Swimers/Bicycle-Crank-Cadence-Power-Meter/Doc/CadenceSensor_Schematic_Review_2026-11-01_R2.txt

CadenceSensor 原理图第二次复审（2026-11-01）

结论：上轮两项主要问题已经修正。对本次四页SVG的静态复核，未发现新的、
明确会阻止既定基本功能的严重连接或标称取值错误。可推进PCB布局与样机验证。
此结论不等于ERC通过、封装映射通过或整机实测通过；尚未锁定的物料参数见下文。

范围：Hardware/原理图/Schematic1下四页2026-11-01.svg。
全部重新读取、渲染检查；对C20、D2及其周围符号/导线检查SVG结构。
没有修改原始原理图，没有执行原始EDA的ERC、PCB DRC或上电测试。
固定10kΩ电阻为用户既定需求，本次保留，不作为待修改项。

一、上轮发现的闭环结果

1. DEC1去耦：已修正。
   C20现在为100nF，连接U3 pin1/DEC1与GND，符合QFAA参考配置。
   C13仍为DEC3到GND的100pF，正确。
   DEC2留空、DEC4的C21=1µF、VDD的C18=4.7µF及C14/C16各100nF保持合理。

2. 蜂鸣器续流：已补入，方向正确。
   新增D2=1N4148W并联在MLT-5020两端：
   阴极K接VOUT/蜂鸣器正端，阳极A接蜂鸣器负端/Q3漏极。
   正常驱动时D2反偏，关断时提供线圈电流续流路径。
   Q3 AO3400A源极接GND，漏极接蜂鸣器负端，P0.23经R28=100Ω驱动栅极，
   R30=1MΩ提供下拉，拓扑成立。
   1N4148W可作为快速续流器件候选，不需要因为其为信号二极管就一概否定。
   但必须锁定实际厂商/订货号，用相应手册核算重复峰值电流、平均电流和温升。
   不能把不同厂家的同名1N4148W额定值混用，也不能用一次性浪涌值代替重复工作能力。
   发声时用合适PWM，首板检查漏极尖峰、VOUT跌落、声压和器件温升。

二、当前关键连接复核

电源与充电：
  nPM1100的SW经L2=2.2µH到VOUT，反馈端接电感后输出，DEC/VSYS/VBAT各有对应去耦。
  pin2/pin3为高，对应3.0V；pin4/pin23/EP接地，图面连接成立。
  R11=30kΩ对应约20mA充电，VTERMSET高为标准版本4.2V目标。
  VOUT直接并联电容仍约15.3µF标称，不把DEC和RESET电容算入。
  CC1/CC2各5.1kΩ下拉；USB数据脚并接至PMIC，未见新的VBUS/GND短接。

关机/唤醒：
  POWER_OFF用P0.22；经R8=1kΩ和BAS116正向驱动SHPACT。
  R9=100kΩ位于GPIO侧下拉，R24=500kΩ位于SHPACT侧下拉。
  SW2从VBAT驱动SHPACT时，BAS116反向隔离MCU，未见VBAT直灌GPIO路径。
  SHPHLD只接R25=100kΩ上拉和SW3到GND，唤醒不依赖MCU上电。
  固件须满足Ship条件：VBUS断开并充分下降、SHPHLD高、SHPACT高至少200ms。
  开机按键SHPHLD低至少200ms；插USB也会唤醒。

MCU、复位与调试：
  三个VDD脚和全部地/裸露焊盘连接维持正确，DC/DC与两组晶振连接未见新误接。
  SW4与C19已接P0.21/RESET，不再接P0.10；SW4的3/4脚未跨接RESET/GND。
  H3定义：1=GND，2=VOUT/VTref，3=P0.21，4=SWDCLK，5=SWDIO。
  SW5为P0.11经R13=1kΩ到按键再到GND，固件需输入上拉。
  P0.21硬件RESET仍需UICR.PSELRESET配置。

加速度计：
  SC7A20H供电/去耦、GND/GNDIO、pin4接地、CS/SDO拉高与4.7kΩ上拉成立。
  I²C地址0x19，INT1接P0.13；未接INT2不阻碍使用INT1。

ADC与应变桥：
  SCLK到pin1，CS到pin2，DIN/DOUT/DRDY与MCU分配一致。
  3V模拟/数字供电、各100nF去耦、共地、CLK接地正确。
  AIN0/1接两桥臂中点，R22/R23各1kΩ、C7跨输入100nF，半桥结构成立。
  四个350Ω桥臂连续激励约8.57mA；这属于既定功耗取舍，不作为接线错误。
  外部参考脚当前未接源，固件不可选这些悬空脚作参考。

电池采样：
  Q1控制分压路径、R6=1.5MΩ/R7=220kΩ维持正确。
  4.2V电池对应约0.537V；源阻抗约192kΩ，SAADC采集时间建议20µs或更长。

三、还需完成的工程核对（与“新增严重接线错误”区分）

1. U2库文字仍需修正：pin3应为VOUTBSET0，pin4应为AVSS。
   当前分别写作VOUTBSET2、NC；实体连线正确，但库电气类型和PCB焊盘必须一起核对。
2. 完整BOM：晶振CL/ESR/精度、L2至少350mA的电流能力及DCR、MLCC偏压降容、
   350Ω桥臂精度/温漂、天线及全部封装映射尚不能仅凭SVG文字确认。
3. 蜂鸣器加入后，实测PWM峰值/平均负载，确认与无线、电桥同时工作时满足
   nPM1100的150mA供电能力，不以400mA短路限制作为正常工作能力。
4. 对ISET/MODE确认上电/复位期间确定电平；正常工作时由固件明确初始化。
5. 蜂鸣器R28=100Ω和R30=1MΩ不是当前明确的严重错误；可按驱动波形和抗扰目标
   评估330Ω栅极串阻及100kΩ下拉，不要求无依据地继续更换器件。
6. RF与模拟性能取决于后续布局、回流、天线净空、安装金属环境及标定，不能由SVG保证。

四、建议进入下一阶段的验证顺序

  A. 修库并锁BOM，原始EDA运行ERC，核对所有封装引脚和跨页网络。
  B. PCB完成后运行DRC，审查RF参考结构、电源回路、ADC输入及回流。
  C. 限流上电测各电源，验证SWD/复位、I²C身份及SPI寄存器回读。
  D. 测蜂鸣器漏极/电流/VOUT瞬态，以及其对ADC零点的影响。
  E. 测按键/GPIO关机、按键/USB唤醒、Ship电流与基本负载标定。

本次文件SHA256（固定本报告所审阅版本）：
POWER_MANAGEMENT: bb968e42b5c7332a77c9e24a6f03af16ad979e5ad7439b24f14c1aff322ced77
NRF52832_CORE_RF: 0fad743ca535fc436a7543a417cb64fc285b46d731420940ea0d7a61f025206b
SC7A20H_SENSOR: 6845124e2240f5803672248ecea050c5fe68a393cf399f63cb17c3dc72e3819a
ADS1220_STRAIN: 63bb2a94d8f3483bb749cd8f81aa7866bbf3550b0bddcbf3a4d9f8863cf369e8

主要参考：
https://docs.nordicsemi.com/r/bundle/ps_nrf52832/page/ref_circuitry.html
https://www.diodes.com/part/view/1N4148W/
https://www.vishay.com/docs/86356/1n4148w.pdf
上述两家二极管资料用于说明同型号存在额定条件差异，不能代替实际采购BOM。
