Swimers/Bicycle-Crank-Cadence-Power-Meter/Doc/CadenceSensor_Uploaded_Schematic_Review_2026-10-30.txt

CadenceSensor 上传版四页SVG审阅与关键物料核查（2026-10-30）

结论：没有发现新的VBAT直灌MCU路径，关机隔离、SPI、核心供电拓扑基本成立。
但仍有确定的复位按键网络错误，以及电磁蜂鸣器缺少钳位、3V驱动选型保证不足。
应先处理这些问题，再进行PCB/ERC和上电验证。
目前不能把所有元器件型号与取值认定为已通过：晶振、电感、电容、天线及精密电阻
缺少完整物料规格，蜂鸣器也需要锁定厂家和版本。

审阅对象：本次用户上传的临时目录文件，不以仓库里较早的SVG代替：
SCH_Schematic1_1-POWER_MANAGEMENT_2026-10-30 (2).svg
SCH_Schematic1_2-NRF52832_CORE_RF_2026-10-30 (2).svg
SCH_Schematic1_3-SC7A20H_SENSOR_2026-10-30 (2).svg
SCH_Schematic1_4-ADS1220_STRAIN_2026-10-30 (2).svg
已逐页渲染，检查关键网络标签及部分引脚/导线的SVG坐标，并对照器件资料。
没有原始EDA网络表、完整BOM和PCB，未执行ERC/DRC或上电实测，未修改原图。
电池NTC使用固定10kΩ是用户确认的需求，本次不列为修改项。

一、需要优先处理的问题

1. [确定的连接错误] 第2页 SW4/C13接P0.10，而不是P0.21/RESET。
   本次SW4已只使用常开1/2脚，原3/4脚跨接导致短路的问题已解除。
   但是SW4上端与C13上端的网络标签现在是P0.10；MCU的真正RESET脚是
   U3 pin24=P0.21，H3 pin3也仍接P0.21，二者没有与该按键相连。
   结果：按SW4只能把P0.10拉低，不能作为P0.21硬件复位按键。
   修改：将SW4/C13上端网络名改为P0.21（或全部统一为RESET网络）。
   P0.21作为复位脚仍需正确设置UICR.PSELRESET。
   C13=100nF本身可以保留；SW4 pin3/pin4按实际器件机械/壳脚要求处理。

2. [器件保护缺失] 第2页 MLT-5020电磁无源蜂鸣器没有外部续流或钳位路径。
   这次Q2的图形方向已正确：源极到GND，漏极到蜂鸣器负端。
   但电磁负载关断时会抬高漏极电压，图中没有外部钳位器件，也没有经过核算的
   雪崩吸能设计，不能把MOSFET自身击穿或体二极管当作设计好的续流保护。
   最简单的补法：在蜂鸣器两端并联合适的续流二极管，阴极K接VOUT，阳极A接Q2漏极。
   二极管正向电流须覆盖实际线圈电流，反压、速度和漏电按工作条件选择。
   简单续流会影响电磁电流衰减和声压，最终需按蜂鸣器厂家参考驱动验证；
   如使用更高压钳位，也要核算MOSFET耐压和脉冲能量。
   MLT-5020应使用约4kHz的合适PWM驱动，不能用长期直流置高代替发声波形。
   不同厂家/版本额定声压、电流和引脚定义可能不同，须锁定完整BOM。

3. [选型保证不足] 2N7002,215不宜直接认定适合3V驱动该蜂鸣器。
   Nexperia手册的RDS(on)保证点为4.5V和10V，3V未给出低导通电阻保证。
   VGS(th)是约0.25mA测试电流下的门限，不代表它能在3V可靠带动电磁负载。
   因此不能断言它必然不响，但目前设计缺少覆盖批次、温度和负载的驱动保证。
   建议换为在VGS=2.5V下明确规定RDS(on)的MOSFET。
   例如AOS AO3400A：2.5V下RDS(on)最大48mΩ（手册规定条件），可作为候选。
   替换时检查引脚/封装：G到栅极串阻，S到地，D到蜂鸣器负端；不能只改型号文字。
   R28=100Ω是合理的栅极串阻量级；换为栅电荷更大的器件时可评估330Ω，
   以限制GPIO瞬态充电电流，4kHz下通常有足够开关时间余量。
   R30=1MΩ可提供下拉，但100kΩ通常有更强的抗干扰和复位关断能力，属于优化项。

4. [待验证的供电裕量] 蜂鸣器与精密采样共用VOUT。
   nPM1100 Buck额定供电能力为150mA，不能以400mA短路限流代替可用输出电流。
   电桥约8.57mA，另有MCU无线峰值、ADC、加速度计和LED。
   新增蜂鸣器后，必须按其实际PWM峰值/平均电流验证总负载、启动电流与VOUT跌落。
   目前没有足够证据证明总负载一定超额，也没有证据证明所有工况都有裕量。
   建议先避免发声与高精度采样重叠，示波器检查供电与ADC噪声；
   如电流或噪声不能满足要求，再调整蜂鸣器供电/器件，而不是任意增大VOUT电容。

二、已经修正并可保留的连接

  - POWER_OFF已经移到U3 P0.22/pin27，不再依赖P0.09的NFC复用。
  - SHPHLD只有VBAT经R25=100kΩ上拉及SW3到GND，没有进入MCU。
  - POWER_OFF经R8=1kΩ接BAS116阳极，阴极接SHPACT；R9=100kΩ在MCU侧下拉。
    按SW2时二极管反偏，可隔离VBAT与MCU；R24=500kΩ保留。
    BAS116实际焊盘应为1=A、3=K、2=NC；SVG隐藏编号，PCB前仍须核对。
  - SW2关机、SW3开机的独立硬件路径成立；无VBUS条件下按键应保持超过200ms。
    自动关机输出高保持至失电；USB接入会唤醒，USB供电时不能靠Ship切断系统。
  - ADS1220 SCLK/CS已正确：ADS_SCK经R18到pin1，ADS_CS经R19到pin2。
  - 47µF电容已删除；VOUT直接并联电容标称总计约15.3µF。

三、关键器件型号与数值核查

主控与传感器：
  U3 nRF52832-QFAA、U1 SC7A20HTR、U4 ADS1220IPWR均能在约3V供电下工作，
  当前I²C/SPI电平相容；ADS1220的AVDD/DVDD应保持在规格范围内（最低2.3V）。
  不存在仅因选了这些芯片型号而互不兼容的问题。

nPM1100及外围：
  U2 NPM1100-QDAA-R：与单节锂电池、USB输入、3V输出目标相符。
  pin2/3接DEC为高/高，输出目标3.0V；pin4/23/25接地，实体连接成立。
  库文字仍错误：pin3应改VOUTBSET0，pin4应改AVSS，同时核对电气类型及焊盘。
  R11=30kΩ：标称20mA充电电流，数值正确，但需要电池允许的充电电流不小于该值。
  VTERMSET高：标准终止电压版本目标4.2V，需与采购电池规格一致。
  R12=10kΩ：按固定电阻方案保留。
  L2=2.2µH：标称值正确；须采购饱和/允许电流至少350mA、DCR不大于400mΩ的型号。
  C8=10µF及其他VOUT电容：实际有效总量须为6~20µF，需计入3V偏压降容、温度和容差。
  C6=10µF、C11=10µF、C2=1µF、C9=2.2µF：标称配置与参考方案一致。
  电容完整料号未给出，不能确认介质、耐压和降容。VBUS电容优先按官方参考选25V；
  其他内部/电池节点需满足其最大电压，输出电容也要保证有效容量下限。
  LED5/6由CHG/ERR恒流下拉驱动，不需要按普通GPIO LED强行补串联限流电阻。

USB：
  CC1/CC2各5.1kΩ下拉正确，D+/D-合并和到PMIC的连接未见误接。
  图面VBUS/GND交叉处没有连接点，但仍须原始EDA高亮网络确认。
  ISET不是电池充电电流设置；上电和复位时应保持低，不能对SDP端口未经协商取500mA。

nRF外围：
  DEC1 100nF、DEC3 100pF、DEC2的C20不焊、DEC4 1µF与参考拓扑一致。
  L6=10µH、L3=15nH、L5=3.9nH、C17=0.8pF的标称值与QFAA参考电路一致。
  RF小电容应采用C0G/NP0，电感高频特性和PCB布局必须满足Nordic参考要求。
  X1只给32MHz、X2只给32.768kHz，缺少完整料号，因此12pF负载电容暂不能最终确认。
  近似CL=C1*C2/(C1+C2)+寄生；两颗12pF只形成约6pF的串联等效外加寄生。
  必须按实际晶振CL/ESR/精度、管脚及负载重新核算，不应把“参考图相同”当作物料已合格。
  AN2051-245缺少完整厂家资料和PCB，当前只能确认RF链路拓扑，不能确认天线匹配/净空。

SC7A20H：
  SDA/SCL各4.7kΩ、供电各100nF合理；CS/SDO拉高、地址0x19、pin4接地正确。
  INT1到MCU，INT2未接MCU不影响使用INT1。

ADS1220与电桥：
  SPI各47Ω、AVDD/DVDD各100nF、CLK接地、AIN0/AIN1差分连接合理。
  R4/R16=350Ω适用于两片350Ω应变片；不能换成330Ω或360Ω后仍假定桥路平衡。
  建议固定桥臂至少0.1%并采用低温漂/良好比值跟踪的电阻；图中没有精度和温漂规格。
  仅标350Ω不足以保证零点及高PGA增益下不饱和，需同时考虑应变片初始阻值公差。
  例如固定桥臂上下各相反1%误差，在3V下可造成约15mV中点失调；
  参考3V且增益128时满量程差分仅约±23.4mV，失调会明显占用动态范围。
  R22/R23各1kΩ、C7=100nF合理，纯外部差分RC极点约796Hz，计桥臂源阻抗后约677Hz。
  具体带宽还取决于ADC数字滤波；参考源选AVDD-AVSS可实现比例测量。
  无载中点应接近VOUT/2；最初用低增益检查失调和符号，再提高增益。

电池测量及人机接口：
  DMC2400UV控制拓扑和R3/R5各1MΩ、R6=1.5MΩ、R7=220kΩ数值合理。
  分压比0.127907，4.2V时BAT_MON约0.537V；源阻抗约192kΩ，SAADC采集时间建议20µs。
  LED串联1kΩ、用户按键串联1kΩ可保留，用户按键需输入上拉。
  蜂鸣器与LED8仍共用P0.12，会联动；需要独立控制时分配两个GPIO。
  电桥8.57mA持续激励及LED7常亮属于续航取舍，不属于新接线错误。

四、投板前应完成的确认

修改SW4网络、补蜂鸣器钳位、确认/更换Q2并锁定蜂鸣器物料。
补充完整BOM：晶振、L2、RF器件、MLCC、精密350Ω电阻和天线。
在原始EDA检查全部跨页网络与焊盘，执行ERC/PCB DRC。
限流上电后检查VOUT启动/负载瞬态、SWD及RESET、I²C身份和SPI寄存器回读。
验证蜂鸣器PWM工作及关闭电流，再分别验证按键/GPIO关机和按键/USB唤醒。

主要参考：
https://assets.nexperia.com/documents/data-sheet/2N7002.pdf
https://www.aosmd.com/sites/default/files/res/datasheets/AO3400A.pdf
https://docs.nordicsemi.com/r/bundle/ps_npm1100/page/product_overview.html
https://docs.nordicsemi.com/r/bundle/ps_npm1100/page/chapters/core_components/buck/doc/frontpage.html
https://store.rakwireless.com/products/wisblock-buzzer-module-rak18001
RAK资料用于核实其采用的Jiangsu MLT-5020是PWM驱动器件，不代替本项目采购版本完整手册。
其他芯片引脚及参考配置沿用此前已读取的本地官方手册，本次逐图复核连接。
