Swimers/Bicycle-Crank-Cadence-Power-Meter/THIRD_PARTY_NOTICES.md

# 第三方资料说明

根目录 [LICENSE](LICENSE) 仅覆盖项目贡献者原创且有权许可的内容，不对第三方资料重新授权。

| 内容 | 相关权利人 / 来源 | 许可处理 |
| --- | --- | --- |
| `Hardware/元器件/NPM1100/`、`Hardware/元器件/NRF52832/` 中的厂商文档和参考设计 | Nordic Semiconductor 及相关原权利人 | 保留原始声明，适用原文件中的使用、修改和再分发条款 |
| `Hardware/元器件/ADS1220/` 中的器件手册 | Texas Instruments | 适用原手册中的版权及使用条款 |
| `Hardware/元器件/SC7A20H/` 中的器件手册 | 士兰微及相关原权利人 | 适用原手册中的版权及使用条款 |
| 工程引用的器件符号、封装、模型，以及从厂商参考设计转换或派生的内容 | 对应厂商、EDA 库提供方及原作者 | 各自权利仍保留；转换格式或收录工程不改变其原有许可 |

厂商名称、产品名称和商标用于识别相关器件，不表示厂商参与、认可或担保本项目。

第三方资料的具体许可应以原文件及权利人的声明为准。项目的非商业授权不替代其再分发授权；再次发布这些资料前，应核对其对应条款。若某项资料缺少明确授权，不应仅凭其可公开下载就认定允许任意再分发。
