Swimers/Bicycle-Crank-Cadence-Power-Meter/Hardware/元器件/NPM1100/nPM1100_Config3_reference_circuit.png

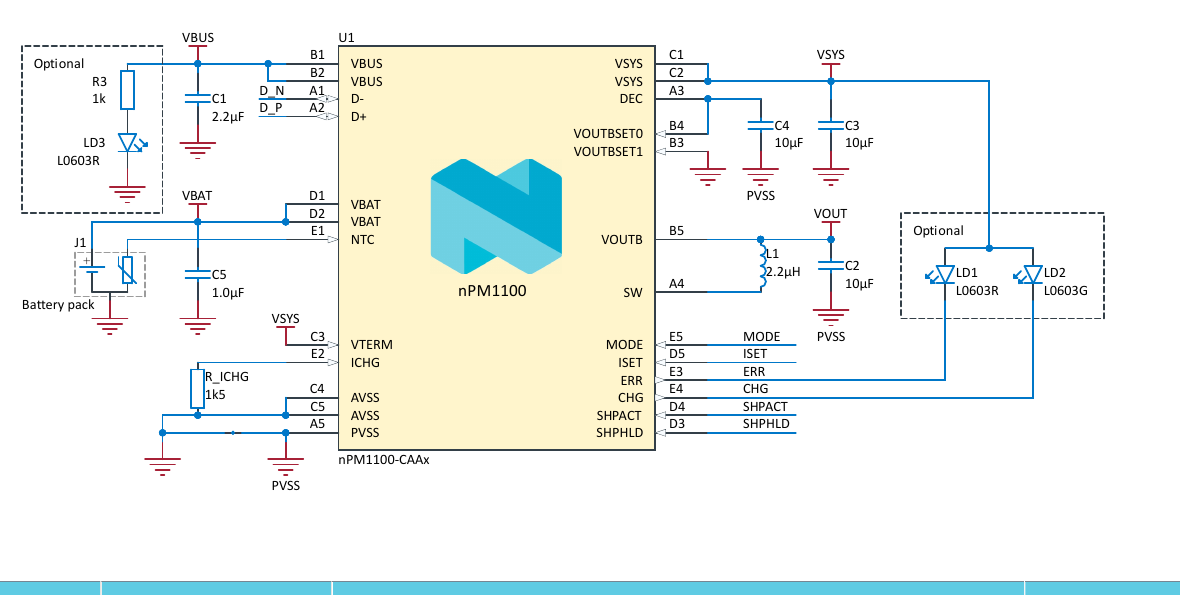
Hardware/元器件/NPM1100/nPM1100_Config3_reference_circuit.png
