Swimers/Bicycle-Crank-Cadence-Power-Meter/Hardware/元器件/NPM1100/屏幕截图 2026-10-27 164939.png

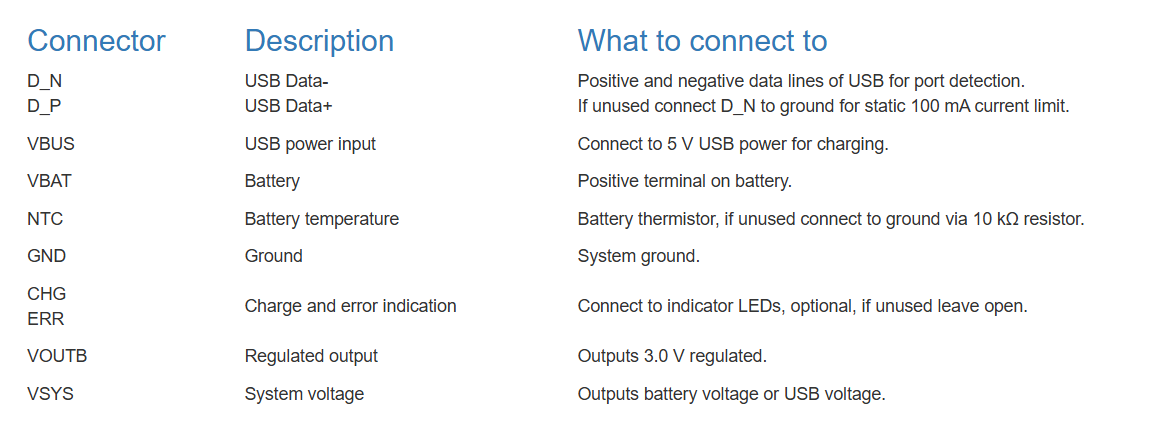
Hardware/元器件/NPM1100/屏幕截图 2026-10-27 164939.png
