Swimers/Bicycle-Crank-Cadence-Power-Meter/Hardware/元器件/NPM1100/Production files/BOM/PCA20057_BOM_Web.xls

Bill of material
Board: | PCA20057
Version: | 1.0.0
Designator | Value | Description | Assembly | Footprint Doc | Manufacturer | Manufacturer Part Number
C1 | 2.2µF | Capacitor, Ceramic, X5R, ±10%, 25V |  | 0603 | Murata | GRM188R61E225KA12D
C3, C4, C5 | 10µF | CAP CER 10UF 10V X7T 0603 |  | 0603 | Murata | GRM188D71A106MA73
L1 | 2.2µH | FIXED IND 2.2UH 500MA 520 MOHM |  | 0603 | Taiyo Yuden | BRL1608T2R2M
R2 | 0R | Resistor, ±5%, 0.05W |  | 0201 | N.A. | N.A.
U1 | nPM1100-CAAAC0 | Li-Ion/Li-Polymer USB battery charger with a high efficiency buck regulator |  | WLCSP-25 | Nordic Semiconductor | nPM1100-CAAAC0
