Swimers/Bicycle-Crank-Cadence-Power-Meter/Hardware/元器件采购.xlsx

No. |  | 购买数量 | Quantity | Comment | Designator | Footprint | Value | Manufacturer Part | Manufacturer | Supplier Part | Supplier | Unique ID | Name | Device | 3D Model Title | Convert to PCB | Category | Primary Category | Secondary Category
1 |  |  | 3 | LAIL-PZ2.54-2P-W | Battery,SG1,SG2 | HDR-TH_2P-P2.54-H-M-W10.0 |  | LAIL-PZ2.54-2P-W | LAILAN(莱联) | C54950590 | LCSC | gge53,gge72,gge73 | LAIL-PZ2.54-2P-W | LAIL-PZ2.54-2P-W | HDR-TH_2P-P2.54-M-WI-1X2P |  | 连接器:排针 | 连接器 | 排针
16 |  |  | 1 | LAIL-PZ2.54-5P-L | H3 | CONN-TH_LAIL-PZ2.54-5P-L |  | LAIL-PZ2.54-5P-L | LAILAN(莱联) | C54950605 | LCSC | gge86 | LAIL-PZ2.54-5P-L | LAIL-PZ2.54-5P-L | CONN-TH_LAIL-PZ2.54-5P-L |  | 连接器:排针 | 连接器 | 排针
46 |  |  | 1 | U262-161N-4BVC11 | USB2 | USB-3.1-SMD_U262-161N-4BVC11 |  | U262-161N-4BVC11 | XKB Connection(中国星坤) | C319148 | LCSC | gge50 | U262-161N-4BVC11 | U262-161N-4BVC11 | USB-3.1-SMD_16P-L8.9-W7.3-H3.3-P0.5 |  | 连接器:USB连接器 | 连接器 | USB连接器
43 |  |  | 1 | NPM1100-QDAA-R | U2 | QFN-24_L4.0-W4.0-P0.50-TL-EP2.7 |  | NPM1100-QDAA-R | NORDIC | C5816773 | LCSC | gge33 | NPM1100-QDAA-R | NPM1100-QDAA-R | QFN-24_L4.0-W4.0-P0.50-TL-EP2.7 |  | 电源管理:专业电源管理(PMIC) | 电源管理 | 专业电源管理(PMIC)
44 |  | 3 | 1 | nRF52832-QFAA | U3 | QFN-48_L6.0-W6.0-P0.40-BL-EP3.8 | nRF52832-QFAA |  | Nordic Semiconductor |  | Nordic Semiconductor | 1bdc0ab44f99f92d | nRF52832-QFAA | nRF52832-QFAA
45 |  | 1 | 1 | ADS1220IPWR | U4 | TSSOP-16_L5.0-W4.4-P0.65-LS6.4-BL |  | ADS1220IPWR | TI(德州仪器) | C48263 | LCSC | gge71 | ADS1220IPWR | ADS1220IPWR | TSSOP-16_L5.0-W4.4-H1.0-LS6.4-P0.65 |  | ADC/DAC/数据转换:模数转换芯片ADC | ADC/DAC/数据转换 | 模数转换芯片ADC
42 |  | 3 | 1 | SC7A20HTR | U1 | LGA-12_L2.0-W2.0-P0.50-TL |  | SC7A20HTR | SILAN(士兰微) | C19274408 | LCSC | gge66 | SC7A20HTR | SC7A20HTR | LGA-12_L2.0-W2.0-H1.0-P0.50 |  | 传感器:姿态传感器/陀螺仪 | 传感器 | 姿态传感器/陀螺仪
47 |  |  | 1 | 32MHz | X1 | CRYSTAL-SMD_4P-L3.2-W2.5-BL | 32MHz | X322532MOB4SI | YXC(扬兴晶振) | C9009 | LCSC | gge1 | 32MHz | X322532MOB4SI | CRYSTAL-SMD_4P-L3.2-W2.5-BL |  | 振荡器/谐振器:无源晶振 | 振荡器/谐振器 | 无源晶振
48 |  |  | 1 | 32.768kHz | X2 | OSC-SMD_L3.2-W1.5 | 32.768kHz | SF32WK32768D31T002 | TKD(泰晶) | C271654 | LCSC | gge15 | 32.768kHz | SF32WK32768D31T002 | OSC-SMD_L3.2-W1.5-H0.8 |  | Crystal Oscillator/Oscillator/Resonator:Crystals | Crystal Oscillator/Oscillator/Resonator | Crystals
20 |  | 3 | 1 | AN2051-245 | L4 | ANT2051 |  | AN2051-245 | Rainsun(霖昱微) | C99727 | LCSC | gge18 | AN2051-245 | AN2051-245 | ANT-SMD_L5.1-W2.0-H1.2 |  | Radio Frequency Chip/Antenna:Antennas | Radio Frequency Chip/Antenna | Antennas
14 |  |  | 1 | BAS116,215 | D1 | SOT-23_L2.9-W1.3-P1.90-LS2.4-BR |  | BAS116,215 | Nexperia(安世) | C48502 | LCSC | gge54 | BAS116,215 | BAS116,215 | SOT-23-3P_L2.9-W1.3-H1.0-LS2.4-P0.95 |  | 二极管:开关二极管 | 二极管 | 开关二极管
25 |  |  | 1 | DMC2400UV | Q1 | SOT-563-6_L1.6-W1.2-P0.50-LS1.6-BL |  | DMC2400UV | TECH PUBLIC(台舟) | C2940616 | LCSC | gge28 | DMC2400UV | DMC2400UV | SOT-563-6_L1.6-W1.2-P0.50-LS1.6-BL |  | 三极管/MOS管/晶体管:场效应管(MOSFET) | 三极管/MOS管/晶体管 | 场效应管(MOSFET)
26 |  | 20 | 1 | AO3400A | Q3 | SOT-23-3_L2.9-W1.3-P1.90-LS2.4-BR |  | AO3400A | AOS | C20917 | LCSC | gge91 | AO3400A | AO3400A_C20917 | SOT-23-3P_L2.9-W1.3-H1.0-LS2.4-P0.95 |  | 三极管/MOS管/晶体管:场效应管(MOSFET) | 三极管/MOS管/晶体管 | 场效应管(MOSFET)
15 |  | 50 | 1 | 1N4148W | D2 | SOD-123F_L2.7-W1.6-LS3.8-RD |  | 1N4148W | ST(先科) | C81598 | LCSC | gge98 | 1N4148W | 1N4148W_C81598 | SOD-123F_L2.7-W1.6-LS3.8-RD |  | 二极管:开关二极管 | 二极管 | 开关二极管
22 |  |  | 1 | GL0603UG01 | LED4 | LED0603-RD |  | GL0603UG01 | Guiguang light(桂光光电) | C51933293 | LCSC | gge40 | GL0603UG01 | GL0603UG01 | LED0603-RD |  | 光电器件:发光二极管/LED | 光电器件 | 发光二极管/LED
23 |  |  | 2 | GL0603UR01 | LED5,LED6 | LED0603-FD |  | GL0603UR01 | Guiguang light(桂光光电) | C51933292 | LCSC | gge41,gge42 | GL0603UR01 | GL0603UR01 | LED0603_Inf |  | 光电器件:发光二极管/LED | 光电器件 | 发光二极管/LED
24 |  | 3 | 1 | 4kHz | MLT-5020 | BUZ-SMD_L5.0-W5.5-P4.60 | 4kHz | MLT-5020 | 华能 | C94598 | LCSC | gge88 | 4kHz | MLT-5020 | BUZ-SMD_3P-L5.2-W5.2-H2.0-P3.50 |  | 音频器件/振动马达:蜂鸣器 | 音频器件/振动马达 | 蜂鸣器
41 |  | 20 | 4 | TS24CA | SW2,SW3,SW4,SW5 | SW-SMD_2P-TS24CA |  | TS24CA | SHOU HAN(首韩) | C393942 | LCSC | gge46,gge47,gge63,gge87 | TS24CA | TS24CA | SW-SMD_2P-TS24CA |  | 按键/开关:轻触开关 | 按键/开关 | 轻触开关
2 |  |  | 6 | 100nF | C1,C3,C7,C16,C19,C20 | C0402 | 100nF | FCC0402B104K160AT | FOJAN(富捷) | C5137468 | LCSC | gge69,gge70,gge83,gge92,gge92_0,gge92_1 | 100nF | FCC0402B104K160AT | C0402_L1.0-W0.5-H0.5 |  | 电容:贴片电容(MLCC) | 电容 | 贴片电容(MLCC)
3 |  |  | 1 | 1uF | C2 | C0402 | 1uF | FCC0402X105K100AT | FOJAN(富捷) | C5137473 | LCSC | gge34 | 1uF | FCC0402X105K100AT | C0402_L1.0-W0.5-H0.5 |  | 电容:贴片电容(MLCC) | 电容 | 贴片电容(MLCC)
4 |  |  | 2 | 100nF | C4,C5 | C0402 | 100nF | 0402B104K500NT | FH(风华) | C110251 | LCSC | gge76,gge77 | 100nF | 0402B104K500NT | C0402_L1.0-W0.5-H0.5 |  | 电容:贴片电容(MLCC) | 电容 | 贴片电容(MLCC)
5 |  |  | 3 | 10uF | C6,C8,C11 | C0402 | 10uF | HGC0402R5106M100NTEJ | Chinocera(华瓷) | C7472949 | LCSC | gge35,gge37,gge45 | 10uF | HGC0402R5106M100NTEJ | C0402_L1.0-W0.5-H0.5 |  | 电容:贴片电容(MLCC) | 电容 | 贴片电容(MLCC)
6 |  |  | 1 | 2.2uF | C9 | C0402 | 2.2uF | GRM155C71A225KE11D | muRata(村田) | C385030 | LCSC | gge38 | 2.2uF | GRM155C71A225KE11D | C0402_L1.0-W0.5-H0.5 |  | 电容:贴片电容(MLCC) | 电容 | 贴片电容(MLCC)
7 |  |  | 2 | 18pF | C10,C15 | C0402 | 18pF | 0402CG180J500NT | FH(风华) | C1549 | LCSC | gge9_4,gge9_6 | 18pF | 0402CG180J500NT | C0402_L1.0-W0.5-H0.5 |  | 电容:贴片电容(MLCC) | 电容 | 贴片电容(MLCC)
8 |  |  | 2 | 20pF | C12,C22 | C0402 | 20pF | 0402CG200J500NT | FH(风华) | C1554 | LCSC | gge9_3,gge9_5 | 20pF | 0402CG200J500NT | C0402_L1.0-W0.5-H0.5 |  | 电容:贴片电容(MLCC) | 电容 | 贴片电容(MLCC)
9 |  |  | 1 | 100pF | C13 | C0402 | 100pF | 0402CG101J500NT | FH(风华) | C1546 | LCSC | gge93 | 100pF | 0402CG101J500NT | C0402_L1.0-W0.5-H0.5 |  | 电容:贴片电容(MLCC) | 电容 | 贴片电容(MLCC)
12 |  |  | 1 | 4.7uF | C18 | C0402 | 4.7uF | CGA0402X5R475M250GT | HRE(芯声) | C6119795 | LCSC | gge95 | 4.7uF | CGA0402X5R475M250GT | C0402_L1.0-W0.5-H0.5 |  | 电容:贴片电容(MLCC) | 电容 | 贴片电容(MLCC)
13 |  |  | 1 | 1uF | C21 | C0402 | 1uF | HGC0402R5105K500NTEJ | Chinocera(华瓷) | C7472948 | LCSC | gge96 | 1uF | HGC0402R5105K500NTEJ | C0402_L1.0-W0.5-H0.5 |  | 电容:贴片电容(MLCC) | 电容 | 贴片电容(MLCC)
10 |  | 100 | 1 | 100nF | C14 | C0603 | 100nF | FCC0603B104K500CT | FOJAN(富捷) | C5137636 | LCSC | gge7_0 | 100nF | FCC0603B104K500CT | C0603_L1.6-W0.8-H0.8 |  | 电容:贴片电容(MLCC) | 电容 | 贴片电容(MLCC)
11 |  | 100 | 1 | 0.8pF | C17 | C0603 | 0.8pF | CC0603BRNPO9BNR80 | YAGEO(国巨) | C519369 | LCSC | gge14 | 0.8pF | CC0603BRNPO9BNR80 | C0603_L1.6-W0.8-H0.8 |  | 电容:贴片电容(MLCC) | 电容 | 贴片电容(MLCC)
27 |  |  | 2 | 4.7kΩ | R1,R2 | R0402 | 4.7kΩ | 0402WGF4701TCE | UNI-ROYAL(厚声) | C25900 | LCSC | gge67,gge68 | 4.7kΩ | 0402WGF4701TCE | R0402_L1.0-W0.5-H0.4 |  | 电阻:贴片电阻 | 电阻 | 贴片电阻
28 |  |  | 2 | 1MΩ | R3,R5 | R0402 | 1MΩ | RC0402FR-071ML | YAGEO(国巨) | C138033 | LCSC | gge29,gge30 | 1MΩ | RC0402FR-071ML | R0402_L1.0-W0.5-H0.4 |  | 电阻:贴片电阻 | 电阻 | 贴片电阻
30 |  |  | 1 | 1.5MΩ | R6 | R0402 | 1.5MΩ | 0402WGF1504TCE | UNI-ROYAL(厚声) | C22276 | LCSC | gge31 | 1.5MΩ | 0402WGF1504TCE | R0402_L1.0-W0.5-H0.4 |  | 电阻:贴片电阻 | 电阻 | 贴片电阻
31 |  |  | 1 | 220kΩ | R7 | R0402 | 220kΩ | 0402WGF2203TCE | UNI-ROYAL(厚声) | C25767 | LCSC | gge32 | 220kΩ | 0402WGF2203TCE | R0402_L1.0-W0.5-H0.4 |  | 电阻:贴片电阻 | 电阻 | 贴片电阻
32 |  |  | 5 | 1kΩ | R8,R10,R13,R22,R23 | R0402 | 1kΩ | 0402WGF1001TCE | UNI-ROYAL(厚声) | C11702 | LCSC | gge39,gge55,gge84,gge85,gge97 | 1kΩ | 0402WGF1001TCE | R0402_L1.0-W0.5-H0.4 |  | 电阻:贴片电阻 | 电阻 | 贴片电阻
33 |  |  | 2 | 100kΩ | R9,R25 | R0402 | 100kΩ | 0402WGF1003TCE | UNI-ROYAL(厚声) | C25741 | LCSC | gge49,gge56 | 100kΩ | 0402WGF1003TCE | R0402_L1.0-W0.5-H0.4 |  | 电阻:贴片电阻 | 电阻 | 贴片电阻
34 |  |  | 1 | 30kΩ | R11 | R0402 | 30kΩ | 0402WGF3002TCE | UNI-ROYAL(厚声) | C25776 | LCSC | gge43 | 30kΩ | 0402WGF3002TCE | R0402_L1.0-W0.5-H0.4 |  | 电阻:贴片电阻 | 电阻 | 贴片电阻
35 |  |  | 1 | 10kΩ | R12 | R0402 | 10kΩ | FRC0402F1002TS | FOJAN(富捷) | C2906861 | LCSC | gge44 | 10kΩ | FRC0402F1002TS | R0402_L1.0-W0.5-H0.4 |  | 电阻:贴片电阻 | 电阻 | 贴片电阻
36 |  |  | 5 | 47Ω | R17,R18,R19,R20,R21 | R0402 | 47Ω | 0402WGF470JTCE | UNI-ROYAL(厚声) | C25118 | LCSC | gge78,gge79,gge80,gge81,gge82 | 47Ω | 0402WGF470JTCE | R0402_L1.0-W0.5-H0.4 |  | 电阻:贴片电阻 | 电阻 | 贴片电阻
37 |  |  | 1 | 500kΩ | R24 | R0402 | 500kΩ | CR205003F | Meritek | C4156264 | LCSC | gge48 | 500kΩ | CR205003F | R0402_L1.0-W0.5-H0.4 |  | 电阻:贴片电阻 | 电阻 | 贴片电阻
38 |  |  | 2 | 5.1kΩ | R26,R27 | R0402 | 5.1kΩ | 0402WGF5101TCE | UNI-ROYAL(厚声) | C25905 | LCSC | gge51,gge52 | 5.1kΩ | 0402WGF5101TCE | R0402_L1.0-W0.5-H0.4 |  | 电阻:贴片电阻 | 电阻 | 贴片电阻
39 |  |  | 1 | 100Ω | R28 | R0402 | 100Ω | 0402WGF1000TCE | UNI-ROYAL(厚声) | C25076 | LCSC | gge89 | 100Ω | 0402WGF1000TCE | R0402_L1.0-W0.5-H0.4 |  | 电阻:贴片电阻 | 电阻 | 贴片电阻
40 |  |  | 1 | 1MΩ | R30 | R0402 | 1MΩ | 0402WGF1004TCE | UNI-ROYAL(厚声) | C26083 | LCSC | gge90 | 1MΩ | 0402WGF1004TCE | R0402_L1.0-W0.5-H0.4 |  | 电阻:贴片电阻 | 电阻 | 贴片电阻
29 | FRC0603F3480TS/ 348o 1% | 100 | 2 | 350Ω | R4,R16 | R0603 | 350Ω | Y1636350R000T9W | VISHAY(威世) | C4240943 | LCSC | gge74,gge75 | 350Ω | Y1636350R000T9W | R0603 |  | 电阻:贴片电阻 | 电阻 | 贴片电阻
17 |  |  | 1 | 10uH | L1 | L0603 | 10uH | LQM18FN100M00D | muRata(村田) | C86083 | LCSC | gge3_0 | 10uH | LQM18FN100M00D | L0603_L1.6-W0.8-H0.5_BEAD |  | 电感/线圈/变压器:贴片电感 | 电感/线圈/变压器 | 贴片电感
18 |  |  | 1 | 2.2uH | L2 | IND-SMD_L1.6-W0.8 | 2.2uH | MBKK1608T2R2M | TAIYO YUDEN(太诱) | C222814 | LCSC | gge36 | 2.2uH | MBKK1608T2R2M | IND-SMD_L1.6-W0.8-H0.7 |  | 电感/线圈/变压器:功率电感 | 电感/线圈/变压器 | 功率电感
21 |  |  | 1 | 3.9nH | L5 | L0603 | 3.9nH | SDCL1608C3N9STDF | Sunlord(顺络) | C13818 | LCSC | gge13 | 3.9nH | SDCL1608C3N9STDF | L0603_L1.6-W0.8-H0.5_BEAD |  | 电感/线圈/变压器:贴片电感 | 电感/线圈/变压器 | 贴片电感
19 |  |  | 1 | 15nH | L3 | L0603 | 15nH | LQW18AN15NG00D | muRata(村田) | C86132 | LCSC | gge4 | 15nH | LQW18AN15NG00D | L0603_L1.6-W0.8-H0.5_BEAD |  | 电感/线圈/变压器:功率电感 | 电感/线圈/变压器 | 功率电感
