Swimers/Bicycle-Crank-Cadence-Power-Meter/Hardware/原理图/SCH_Schematic1_V0.9.pdf

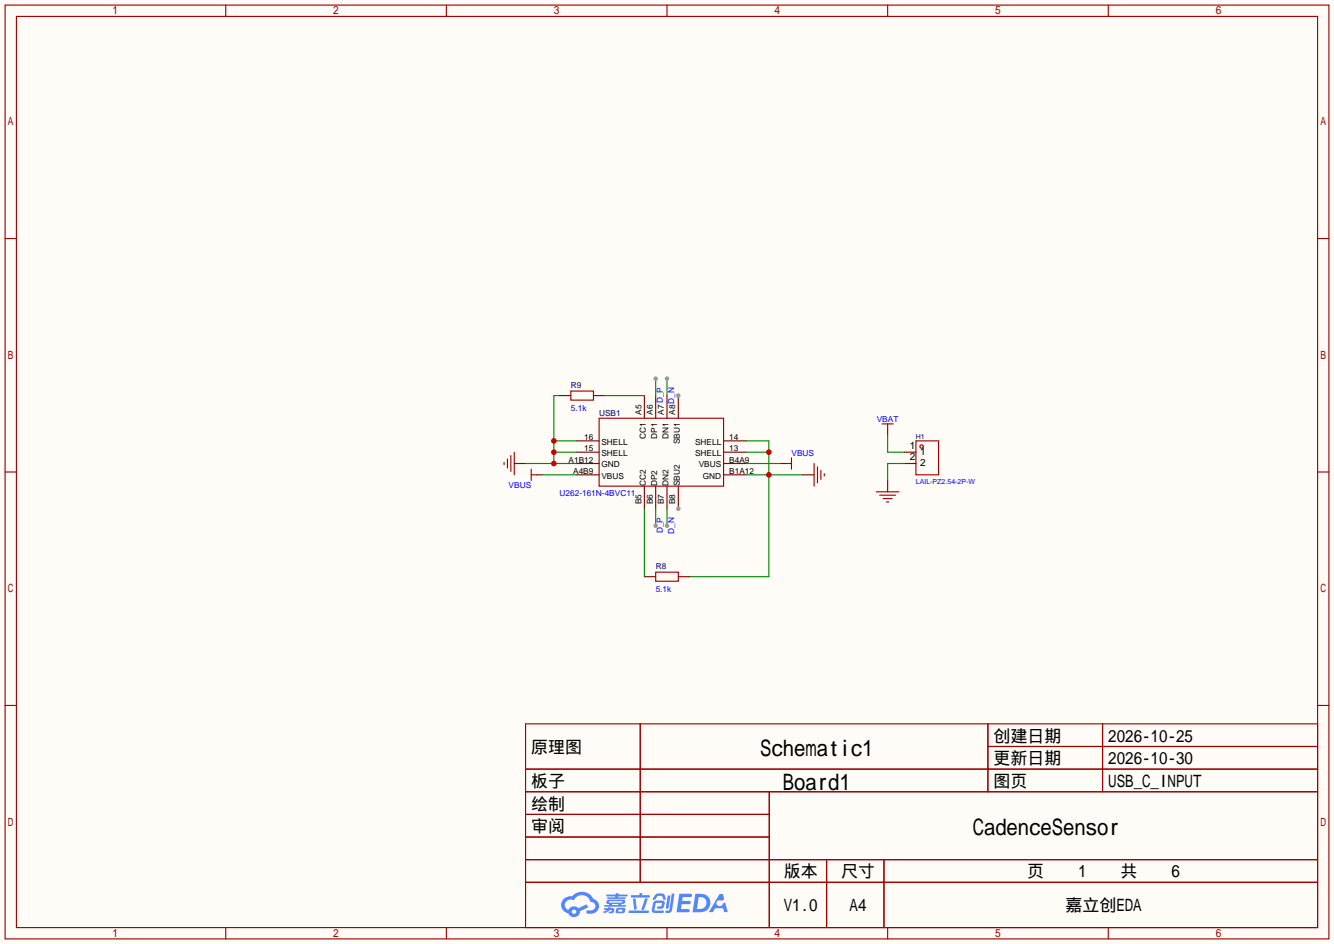
[picture p3: page 1]

原理图 | Schematic1 | 创建日期 | 2026-10-25

更新日期 | 2026-10-30

板子 | Board1 | 图页 | USB_C_INPUT
绘制 | | CadenceSensor
审阅

V1.0 | A4 | 嘉立创EDA

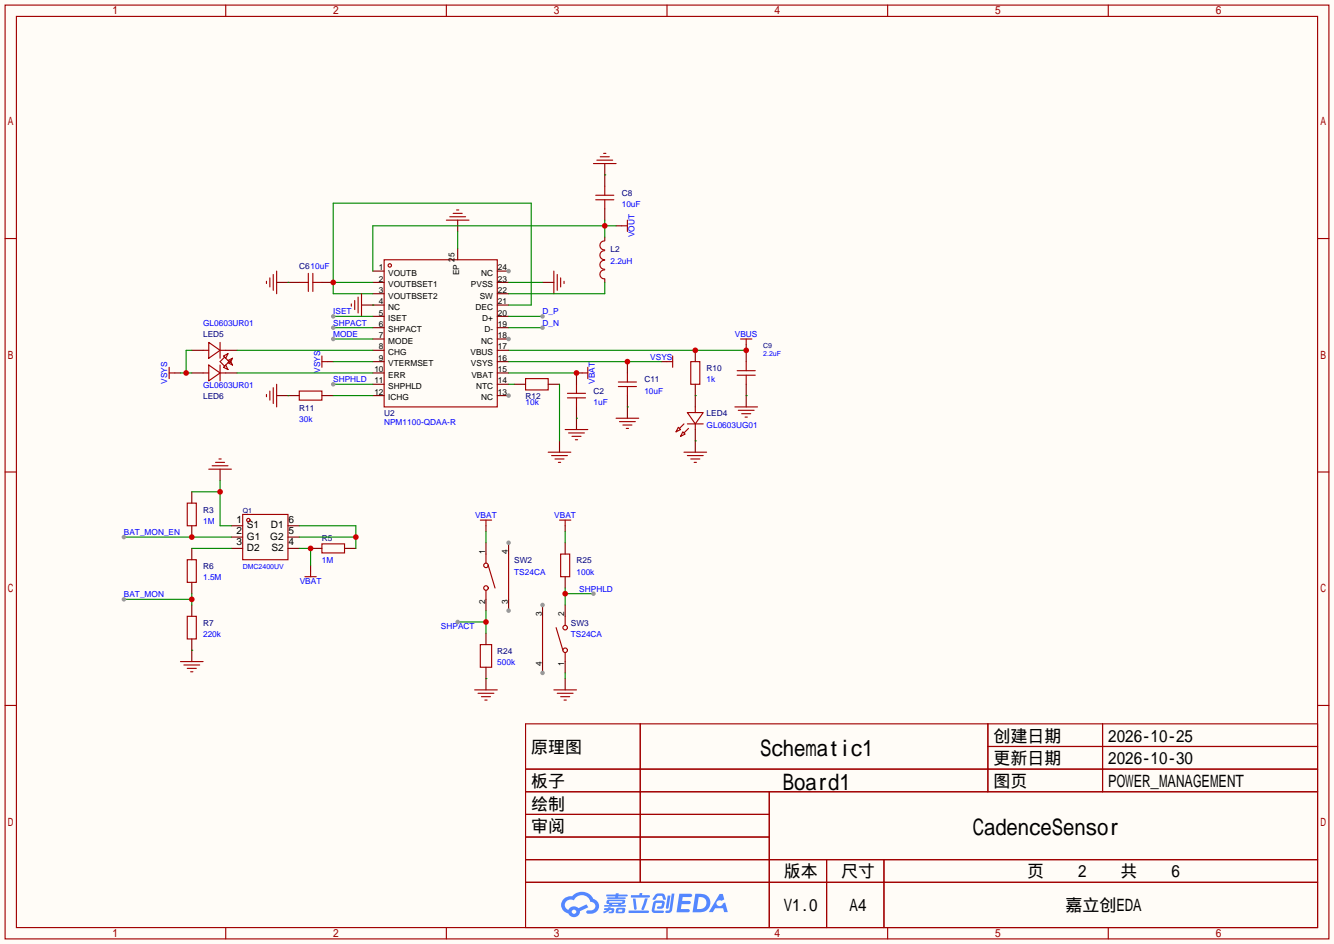
[picture p4: page 2]

原理图 | Schematic1 | 创建日期 | 2026-10-25

更新日期 | 2026-10-30

板子 | Board1 | 图页 | POWER_MANAGEMENT
绘制 | | CadenceSensor
审阅

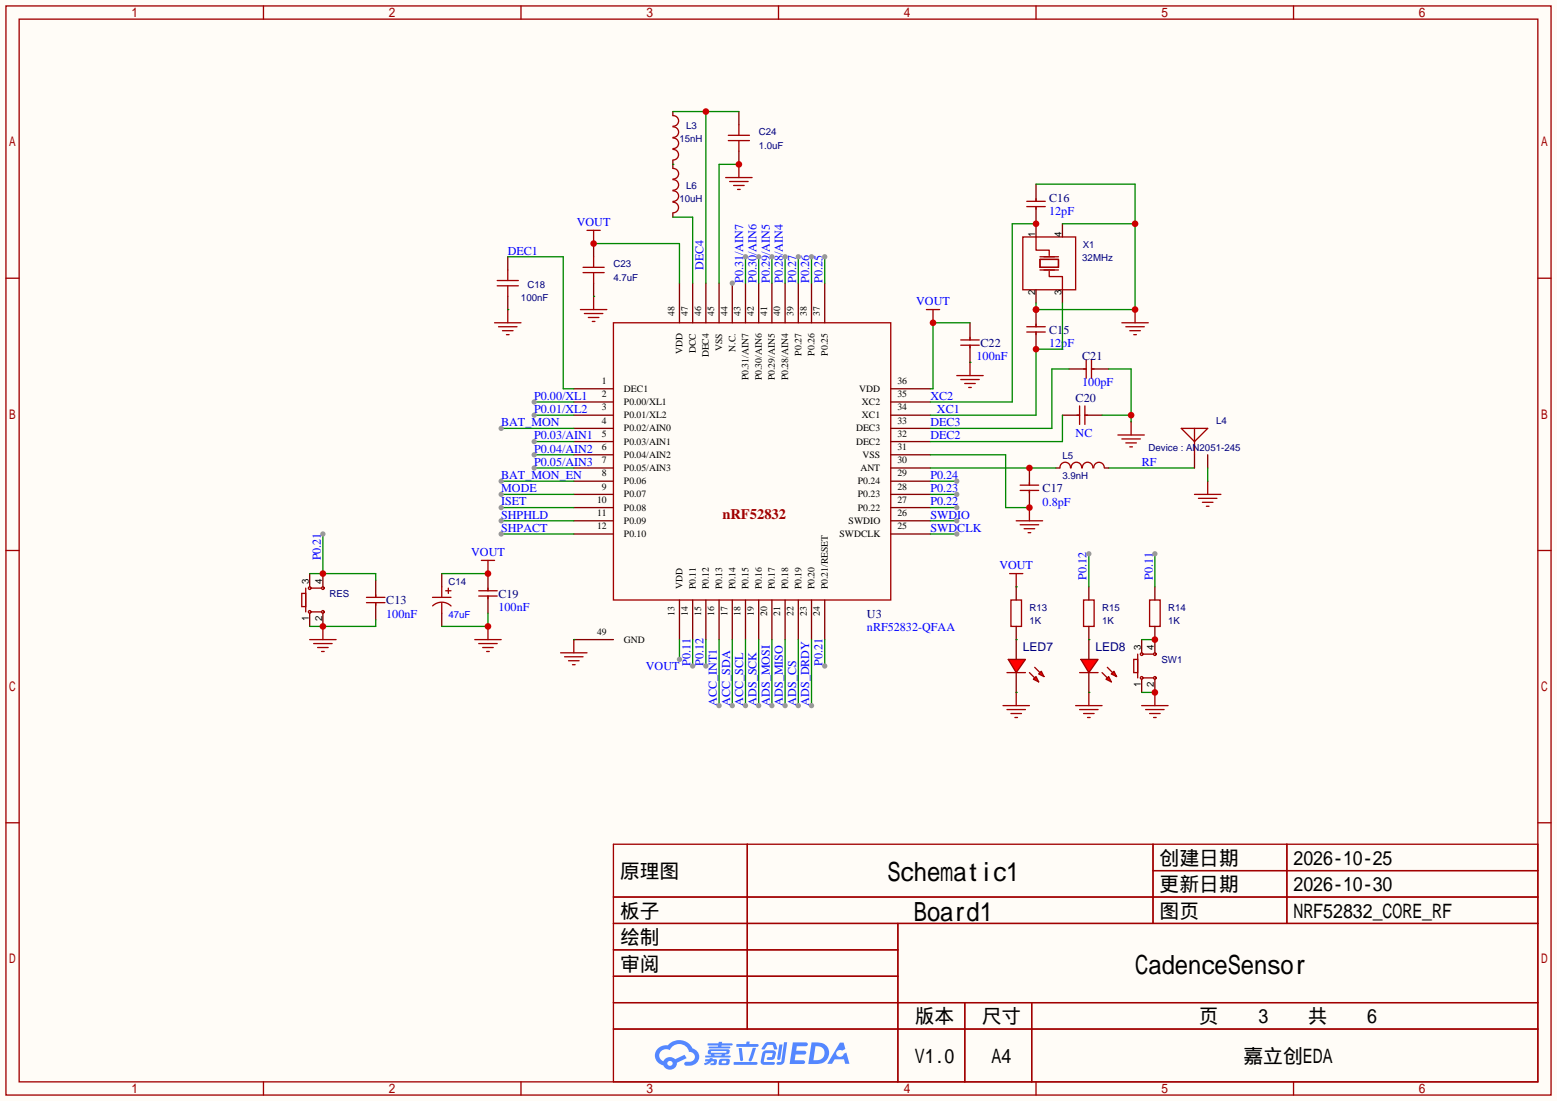
[picture p5: page 3]

原理图 | Schematic1 | 创建日期 | 2026-10-25

更新日期 | 2026-10-30

板子 | Board1 | 图页 | NRF52832_CORE_RF
绘制 | | CadenceSensor
审阅

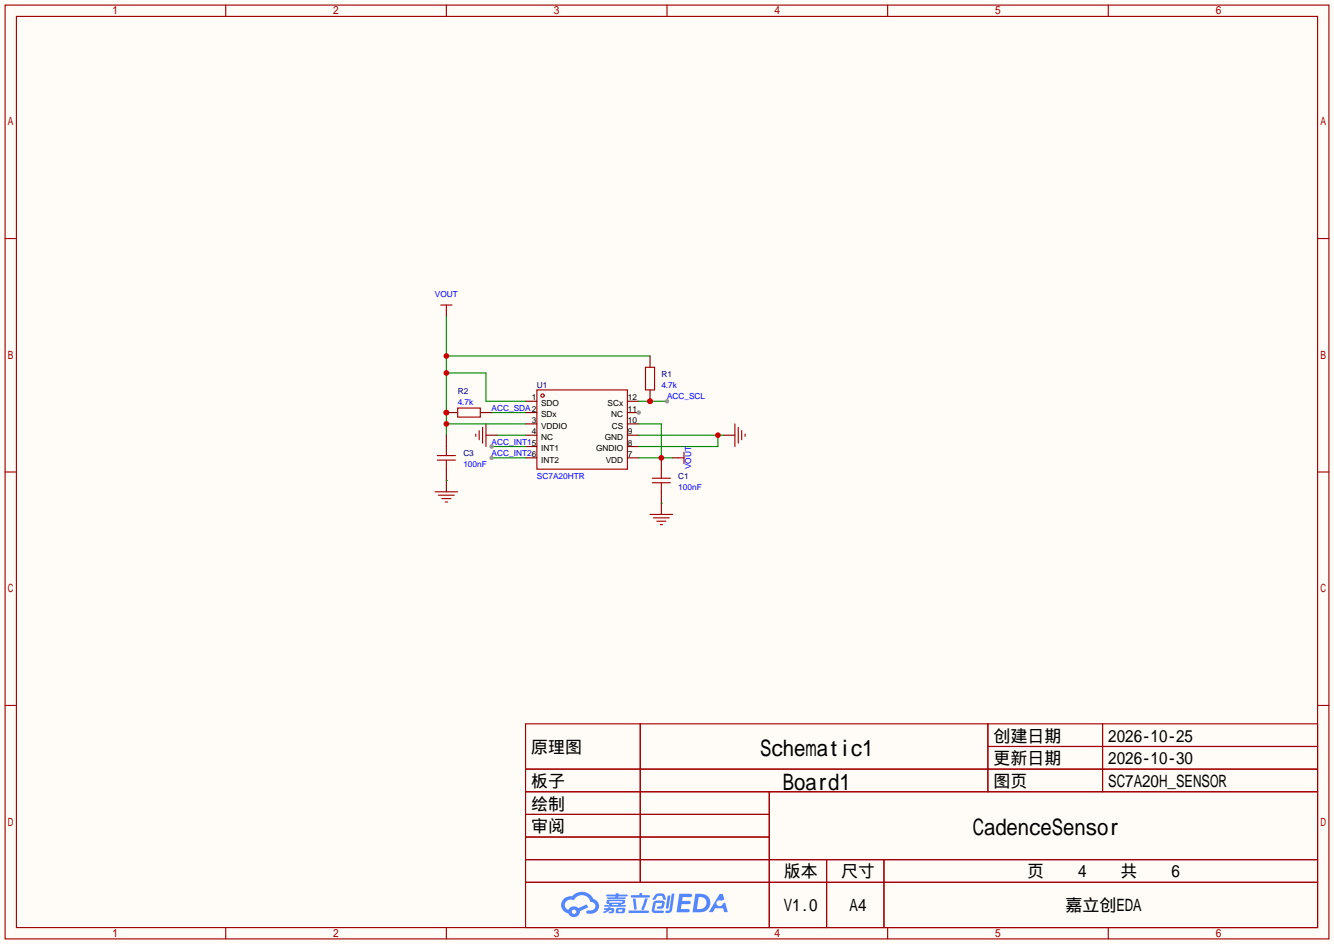
[picture p6: page 4]

原理图 | Schematic1 | 创建日期 | 2026-10-25

更新日期 | 2026-10-30

板子 | Board1 | 图页 | SC7A20H_SENSOR
绘制 | | CadenceSensor
审阅

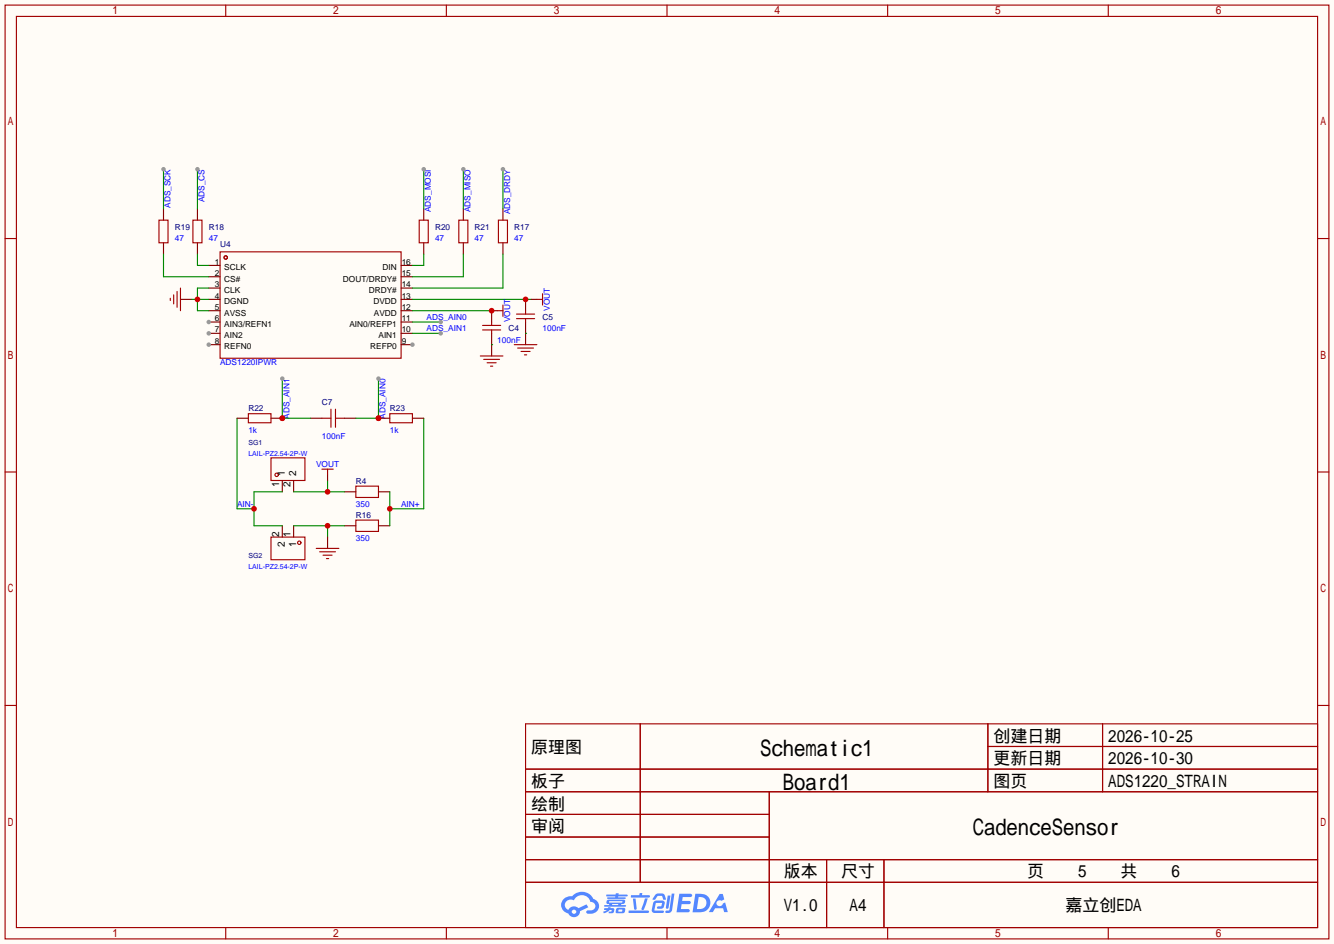
[picture p7: page 5]

AIN1 10 AIN0/REFP1 11 AVDD 12 DVDD 13 DRDY# 14 DOUT/DRDY# 15 DIN 16

原理图 | Schematic1 | 创建日期 | 2026-10-25

更新日期 | 2026-10-30

板子 | Board1 | 图页 | ADS1220_STRAIN
绘制 | | CadenceSensor
审阅

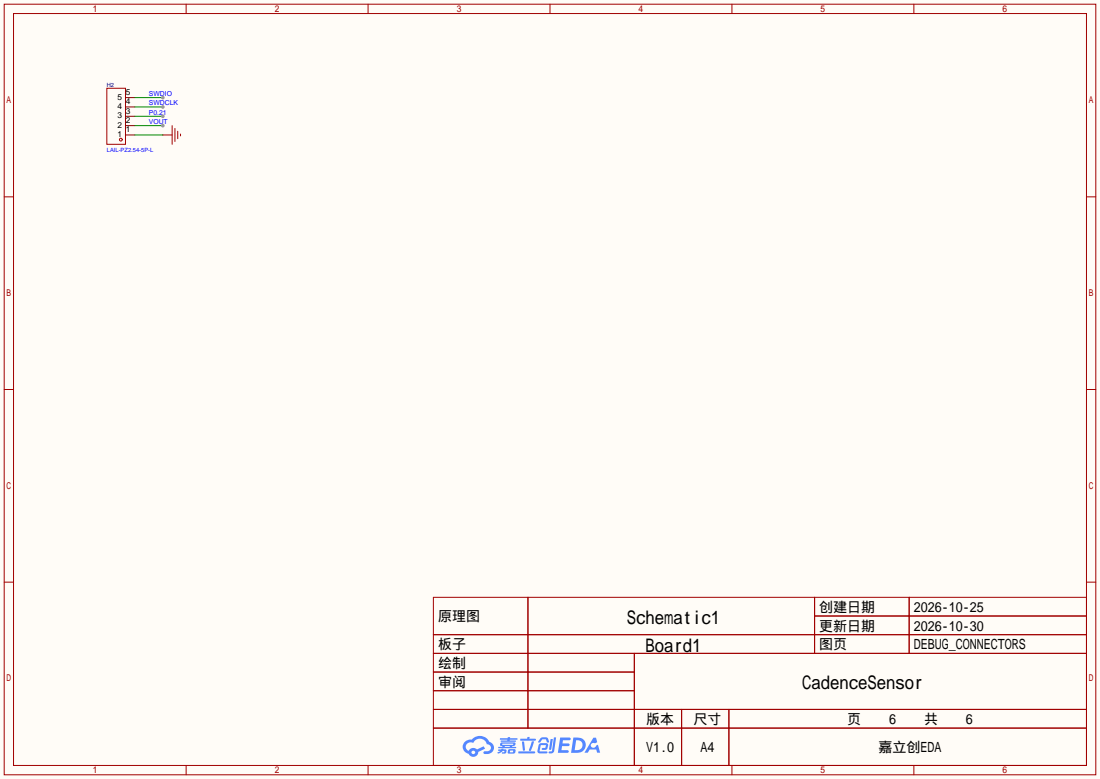
[picture p8: page 6]

原理图 | Schematic1 | 创建日期 | 2026-10-25

更新日期 | 2026-10-30

板子 | Board1 | 图页 | DEBUG_CONNECTORS
绘制 | | CadenceSensor
审阅
