Swimers/Bicycle-Crank-Cadence-Power-Meter/Hardware/PCB/NRF52832/PCB_PCB1_2026-11-02.pdf

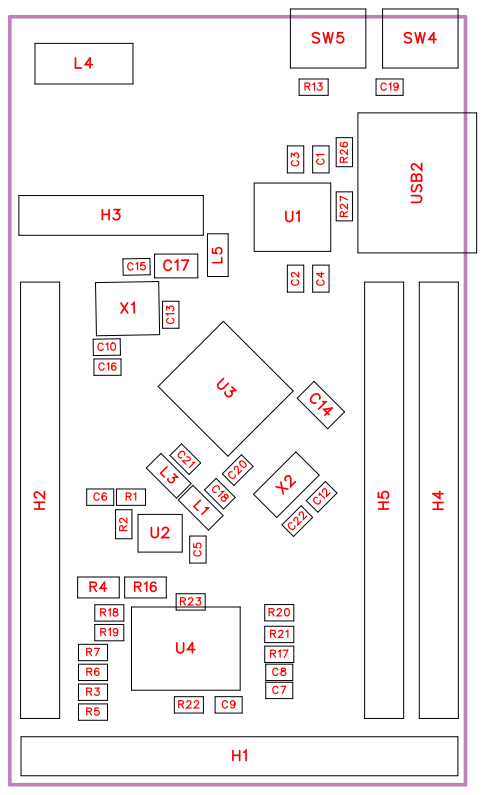
[picture p9: page 1]

No. | Quantity | Comment | Designator | Footprint | Value | Manufacturer Part | Manufacturer | Supplier Part | Supplier
1 | 2 | 10uF | C1,C2 | C0402 | 10uF | HGC0402R5 106M100NT EJ | Chinocera(华 瓷) | C7472949 | LCSC
2 | 8 | 100nF | C3,C4,C5,C6,C9,C16,C19, C20 | C0402 | 100nF | FCC0402B10 4K160AT | FOJAN(富捷) | C5137468 | LCSC
3 | 2 | 100nF | C7,C8 | C0402 | 100nF | 0402B104K5 00NT | FH(风华) | C110251 | LCSC
4 | 2 | 18pF | C10,C15 | C0402 | 18pF | 0402CG180J 500NT | FH(风华) | C1549 | LCSC
5 | 2 | 20pF | C12,C22 | C0402 | 20pF | 0402CG200J 500NT | FH(风华) | C1554 | LCSC
6 | 1 | 100pF | C13 | C0402 | 100pF | 0402CG101J 500NT | FH(风华) | C1546 | LCSC
7 | 1 | 100nF | C14 | C0603 | 100nF | FCC0603B10 4K500CT | FOJAN(富捷) | C5137636 | LCSC
8 | 1 | 0.8pF | C17 | C0603 | 0.8pF | CC0603BRN PO9BNR80 | YAGEO(国巨 ) | C519369 | LCSC
9 | 1 | 4.7uF | C18 | C0402 | 4.7uF | CGA0402X5 R475M250G T | HRE(芯声) | C6119795 | LCSC
10 | 1 | 1uF | C21 | C0402 | 1uF | HGC0402R5 105K500NTE J | Chinocera(华 瓷) | C7472948 | LCSC
11 | 4 | LAIL-PZ2.54-12P-L | H1,H2,H4,H5 | HDR-TH_LAI L-PZ2.54-12 P-L | | LAIL-PZ2.54-12P-L | LAILAN(莱联 ) | C54950623 | LCSC
12 | 1 | LAIL-PZ2.54-5P-L | H3 | CONN-TH_L AIL-PZ2.54-5 P-L | | LAIL-PZ2.54-5P-L | LAILAN(莱联 ) | C54950605 | LCSC
13 | 1 | 10uH | L1 | L0603 | 10uH | LQM18FN10 0M00D | muRata(村田 ) | C86083 | LCSC
14 | 1 | 15nH | L3 | L0603 | 15nH | LQW18AN15 NG00D | muRata(村田 ) | C86132 | LCSC
15 | 1 | AN2051-245 | L4 | ANT2051 | | AN2051-245 | Rainsun(霖昱 微) | C99727 | LCSC
16 | 1 | 3.9nH | L5 | L0603 | 3.9nH | SDCL1608C 3N9STDF | Sunlord(顺络 ) | C13818 | LCSC
17 | 2 | 4.7k | R1,R2 | R0402 | 4.7k | 0402WGF47 01TCE | UNI-ROYAL( 厚声) | C25900 | LCSC
18 | 4 | 0 | R3,R5,R6,R7 | R0402 | 0 | 0402WGF00 00TCE | UNI-ROYAL( 厚声) | C17168 | LCSC
19 | 2 | 350 | R4,R16 | R0603 | 350 | Y1636350R0 00T9W | VISHAY(威世 ) | C4240943 | LCSC
20 | 3 | 1k | R13,R22,R23 | R0402 | 1k | 0402WGF10 01TCE | UNI-ROYAL( 厚声) | C11702 | LCSC
21 | 5 | 47 | R17,R18,R19,R20,R21 | R0402 | 47 | 0402WGF47 0JTCE | UNI-ROYAL( 厚声) | C25118 | LCSC

22 | 2 | 5.1k | R26,R27 | R0402 | 5.1k | 0402WGF51 01TCE | UNI-ROYAL( 厚声 ) | C25905 | LCSC
23 | 2 | TS24CA | SW4,SW5 | SW-SMD_2P -TS24CA | | TS24CA | SHOU HAN(首韩 ) | C393942 | LCSC
24 | 1 | HR1117V-3.3 | U1 | SOT-89-3_L4 .5-W2.4-P1.5 0-LS4.0-BR | | HR1117V-3.3 | R+O(宏嘉诚 ) | C54560864 | LCSC
25 | 1 | SC7A20HTR | U2 | LGA-12_L2.0 -W2.0-P0.50-TL | | SC7A20HTR | SILAN(士兰 微) | C19274408 | LCSC
26 | 1 | nRF52832-Q FAA | U3 | QFN-48_L6.0 -W6.0-P0.40-BL-EP3.8 | nRF52832-Q FAA | | Nordic Semic onductor | | Nordic Semic onductor
27 | 1 | ADS1220IP WR | U4 | TSSOP-16_L 5.0-W4.4-P0. 65-LS6.4-BL | | ADS1220IP WR | TI(德州仪器 ) | C48263 | LCSC
28 | 1 | U262-161N-4 BVC11 | USB2 | USB-3.1-SM D_U262-161 N-4BVC11 | | U262-161N-4 BVC11 | XKB Connect ion(中国星坤 ) | C319148 | LCSC
29 | 1 | 32MHz | X1 | CRYSTAL-S MD_4P-L3.2-W2.5-BL | 32MHz | X322532MO B4SI | YXC(扬兴晶 振) | C9009 | LCSC
30 | 1 | 32.768kHz | X2 | OSC-SMD_L 3.2-W1.5 | 32.768kHz | SF32WK327 68D31T002 | TKD(泰晶 ) | C271654 | LCSC

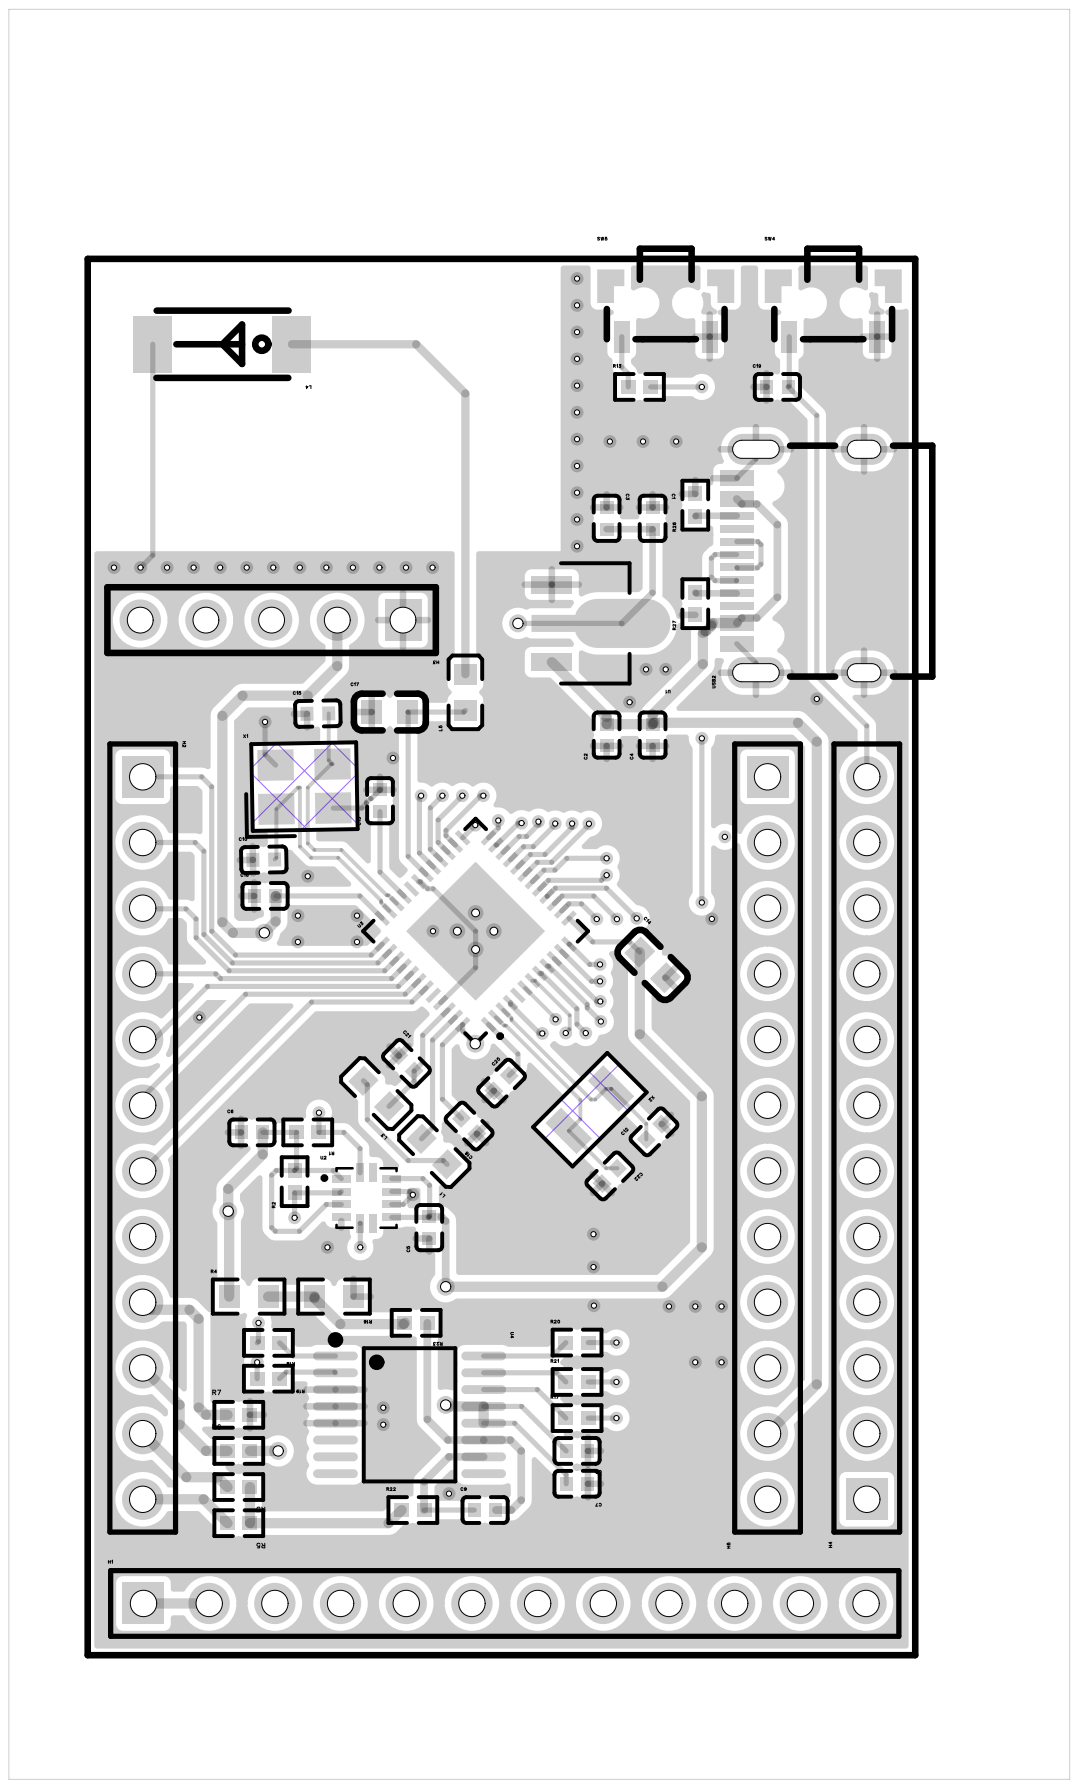
[picture p10: page 5]

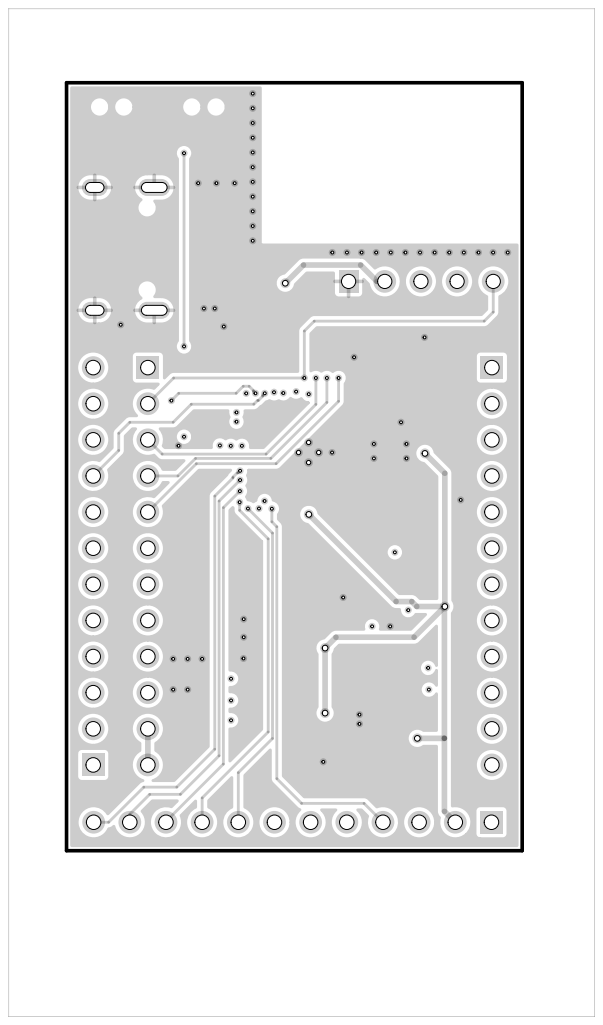
[picture p11: page 6]

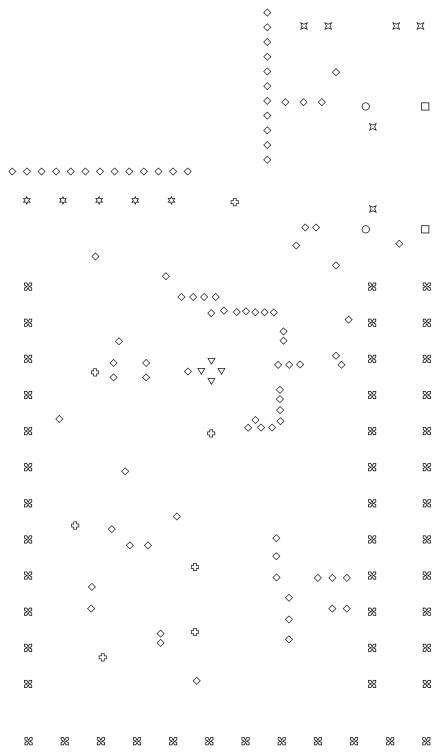
[picture p12: page 7]
