Swimers/Bicycle-Crank-Cadence-Power-Meter/Hardware/PCB/CadenceSensor/PCB_PCB1_2026-11-01.pdf

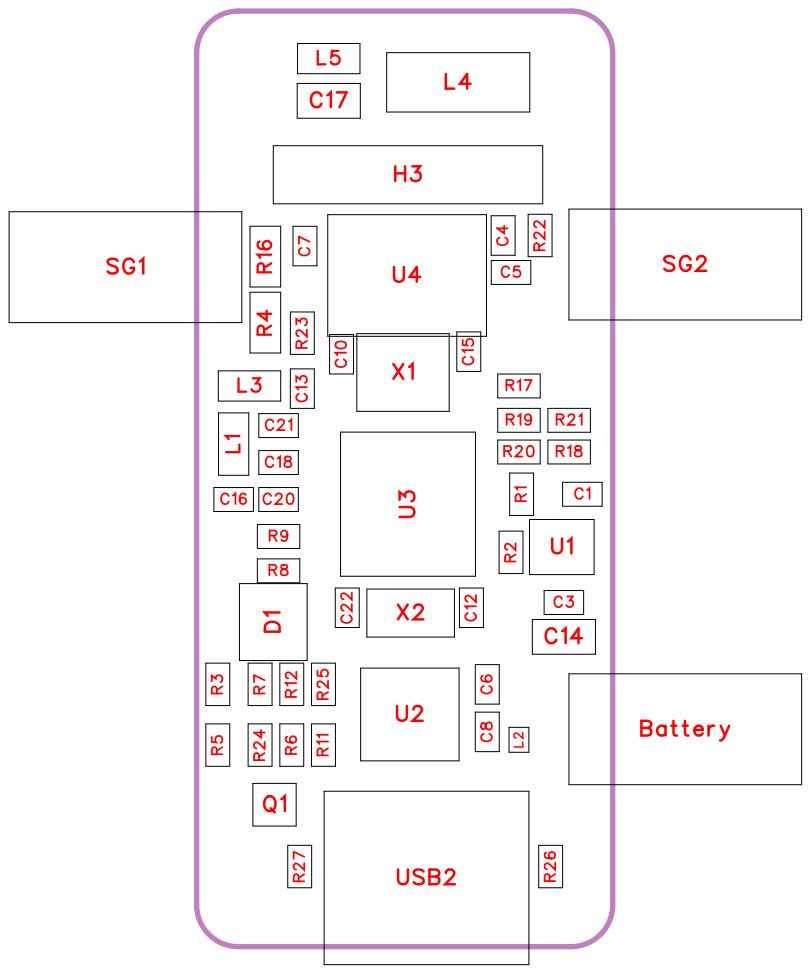
[picture p13: page 1]

C18 | R20 R18
C16 C20 | C1

Battery

Q1 | USB2

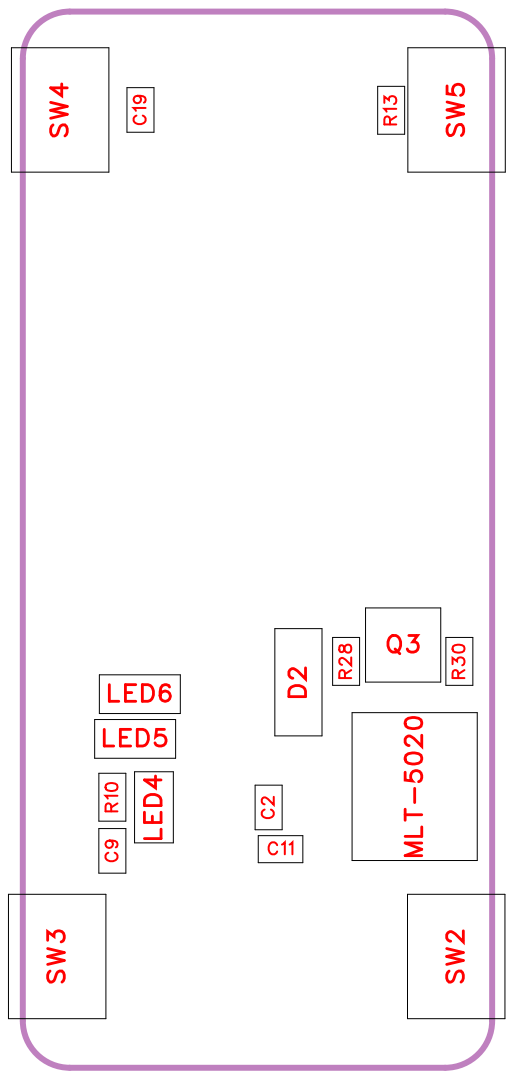
[picture p14: page 2]

No. | Quantity | Comment | Designator | Footprint | Value | Manufacturer Part | Manufacturer | Supplier Part | Supplier
1 | 3 | LAIL-PZ2.54-2P-W | Battery,SG1,SG2 | HDR-TH_2P-P2.54-H-M-W10.0 | | LAIL-PZ2.54-2P-W | LAILAN(莱联 ) | C54950590 | LCSC
2 | 6 | 100nF | C1,C3,C7,C16,C19,C20 | C0402 | 100nF | FCC0402B10 4K160AT | FOJAN(富捷) | C5137468 | LCSC
3 | 1 | 1uF | C2 | C0402 | 1uF | FCC0402X10 5K100AT | FOJAN(富捷) | C5137473 | LCSC
4 | 2 | 100nF | C4,C5 | C0402 | 100nF | 0402B104K5 00NT | FH(风华) | C110251 | LCSC
5 | 3 | 10uF | C6,C8,C11 | C0402 | 10uF | HGC0402R5 106M100NT EJ | Chinocera(华 瓷) | C7472949 | LCSC
6 | 1 | 2.2uF | C9 | C0402 | 2.2uF | GRM155C71 A225KE11D | muRata(村田 ) | C385030 | LCSC
7 | 2 | 18pF | C10,C15 | C0402 | 18pF | 0402CG180J 500NT | FH(风华) | C1549 | LCSC
8 | 2 | 20pF | C12,C22 | C0402 | 20pF | 0402CG200J 500NT | FH(风华) | C1554 | LCSC
9 | 1 | 100pF | C13 | C0402 | 100pF | 0402CG101J 500NT | FH(风华) | C1546 | LCSC
10 | 1 | 100nF | C14 | C0603 | 100nF | FCC0603B10 4K500CT | FOJAN(富捷) | C5137636 | LCSC
11 | 1 | 0.8pF | C17 | C0603 | 0.8pF | CC0603BRN PO9BNR80 | YAGEO(国巨 ) | C519369 | LCSC
12 | 1 | 4.7uF | C18 | C0402 | 4.7uF | CGA0402X5 R475M250G T | HRE(芯声) | C6119795 | LCSC
13 | 1 | 1uF | C21 | C0402 | 1uF | HGC0402R5 105K500NTE J | Chinocera(华 瓷) | C7472948 | LCSC
14 | 1 | BAS116,215 | D1 | SOT-23_L2.9 -W1.3-P1.90-LS2.4-BR | | BAS116,215 | Nexperia(安 世) | C48502 | LCSC
15 | 1 | 1N4148W | D2 | SOD-123F_L 2.7-W1.6-LS 3.8-RD | | 1N4148W | ST(先科) | C81598 | LCSC
16 | 1 | LAIL-PZ2.54-5P-L | H3 | CONN-TH_L AIL-PZ2.54-5 P-L | | LAIL-PZ2.54-5P-L | LAILAN(莱联 ) | C54950605 | LCSC
17 | 1 | 10uH | L1 | L0603 | 10uH | LQM18FN10 0M00D | muRata(村田 ) | C86083 | LCSC
18 | 1 | 2.2uH | L2 | IND-SMD_L1 .0-W0.6_PLE A67BCA4R7 M-1PT00 | 2.2uH | PLEA67BBA 2R2M-1PT00 | TDK | C3911260 | LCSC
19 | 1 | 15nH | L3 | L0603 | 15nH | LQW18AN15 NG00D | muRata(村田 ) | C86132 | LCSC

20 | 1 | AN2051-245 | L4 | ANT2051 | | AN2051-245 | Rainsun(霖昱 微) | C99727 | LCSC
21 | 1 | 3.9nH | L5 | L0603 | 3.9nH | SDCL1608C 3N9STDF | Sunlord(顺络 ) | C13818 | LCSC
22 | 1 | GL0603UG0 1 | LED4 | LED0603-RD | | GL0603UG0 1 | Guiguang lig ht(桂光光电 ) | C51933293 | LCSC
23 | 2 | GL0603UR0 1 | LED5,LED6 | LED0603-FD | | GL0603UR0 1 | Guiguang lig ht(桂光光电 ) | C51933292 | LCSC
24 | 1 | 4kHz | MLT-5020 | BUZ-SMD_L 5.0-W5.5-P4. 60 | 4kHz | MLT-5020 | 华能 | C94598 | LCSC
25 | 1 | DMC2400UV | Q1 | SOT-563-6_L 1.6-W1.2-P0. 50-LS1.6-BL | | DMC2400UV | TECH PUBLI C(台舟 ) | C2940616 | LCSC
26 | 1 | AO3400A | Q3 | SOT-23-3_L2 .9-W1.3-P1.9 0-LS2.4-BR | | AO3400A | AOS | C20917 | LCSC
27 | 2 | 4.7k | R1,R2 | R0402 | 4.7k | 0402WGF47 01TCE | UNI-ROYAL( 厚声 ) | C25900 | LCSC
28 | 2 | 1M | R3,R5 | R0402 | 1M | RC0402FR-0 71ML | YAGEO(国巨 ) | C138033 | LCSC
29 | 2 | 350 | R4,R16 | R0603 | 350 | Y1636350R0 00T9W | VISHAY(威世 ) | C4240943 | LCSC
30 | 1 | 1.5M | R6 | R0402 | 1.5M | 0402WGF15 04TCE | UNI-ROYAL( 厚声 ) | C22276 | LCSC
31 | 1 | 220k | R7 | R0402 | 220k | 0402WGF22 03TCE | UNI-ROYAL( 厚声 ) | C25767 | LCSC
32 | 5 | 1k | R8,R10,R13,R22,R23 | R0402 | 1k | 0402WGF10 01TCE | UNI-ROYAL( 厚声 ) | C11702 | LCSC
33 | 2 | 100k | R9,R25 | R0402 | 100k | 0402WGF10 03TCE | UNI-ROYAL( ) 厚声 | C25741 | LCSC
34 | 1 | 30k | R11 | R0402 | 30k | 0402WGF30 02TCE | UNI-ROYAL( ) 厚声 | C25776 | LCSC
35 | 1 | 10k | R12 | R0402 | 10k | FRC0402F10 02TS | FOJAN(富捷 ) | C2906861 | LCSC
36 | 5 | 47 | R17,R18,R19,R20,R21 | R0402 | 47 | 0402WGF47 0JTCE | UNI-ROYAL( 厚声 ) | C25118 | LCSC
37 | 1 | 500k | R24 | R0402 | 500k | CR205003F | Meritek | C4156264 | LCSC
38 | 2 | 5.1k | R26,R27 | R0402 | 5.1k | 0402WGF51 01TCE | UNI-ROYAL( ) 厚声 | C25905 | LCSC
39 | 1 | 100 | R28 | R0402 | 100 | 0402WGF10 00TCE | UNI-ROYAL( 厚声 ) | C25076 | LCSC
40 | 1 | 1M | R30 | R0402 | 1M | 0402WGF10 04TCE | UNI-ROYAL( 厚声 ) | C26083 | LCSC
41 | 4 | TS24CA | SW2,SW3,SW4,SW5 | SW-SMD_2P -TS24CA | | TS24CA | SHOU HAN(首韩 ) | C393942 | LCSC
42 | 1 | SC7A20HTR | U1 | LGA-12_L2.0 -W2.0-P0.50-TL | | SC7A20HTR | SILAN(士兰 微) | C19274408 | LCSC

43 | 1 | NPM1100-Q DAA-R | U2 | QFN-24_L4.0 -W4.0-P0.50-TL-EP2.7 | | NPM1100-Q DAA-R | NORDIC | C5816773 | LCSC
44 | 1 | nRF52832-Q FAA | U3 | QFN-48_L6.0 -W6.0-P0.40-BL-EP3.8 | nRF52832-Q FAA | | Nordic Semic onductor | | Nordic Semic onductor
45 | 1 | ADS1220IP WR | U4 | TSSOP-16_L 5.0-W4.4-P0. 65-LS6.4-BL | | ADS1220IP WR | TI(德州仪器 ) | C48263 | LCSC
46 | 1 | U262-161N-4 BVC11 | USB2 | USB-3.1-SM D_U262-161 N-4BVC11 | | U262-161N-4 BVC11 | XKB Connect ion(中国星坤 ) | C319148 | LCSC
47 | 1 | 32MHz | X1 | CRYSTAL-S MD_4P-L3.2-W2.5-BL | 32MHz | X322532MO B4SI | YXC(扬兴晶 振) | C9009 | LCSC
48 | 1 | 32.768kHz | X2 | OSC-SMD_L 3.2-W1.5 | 32.768kHz | SF32WK327 68D31T002 | TKD(泰晶 ) | C271654 | LCSC

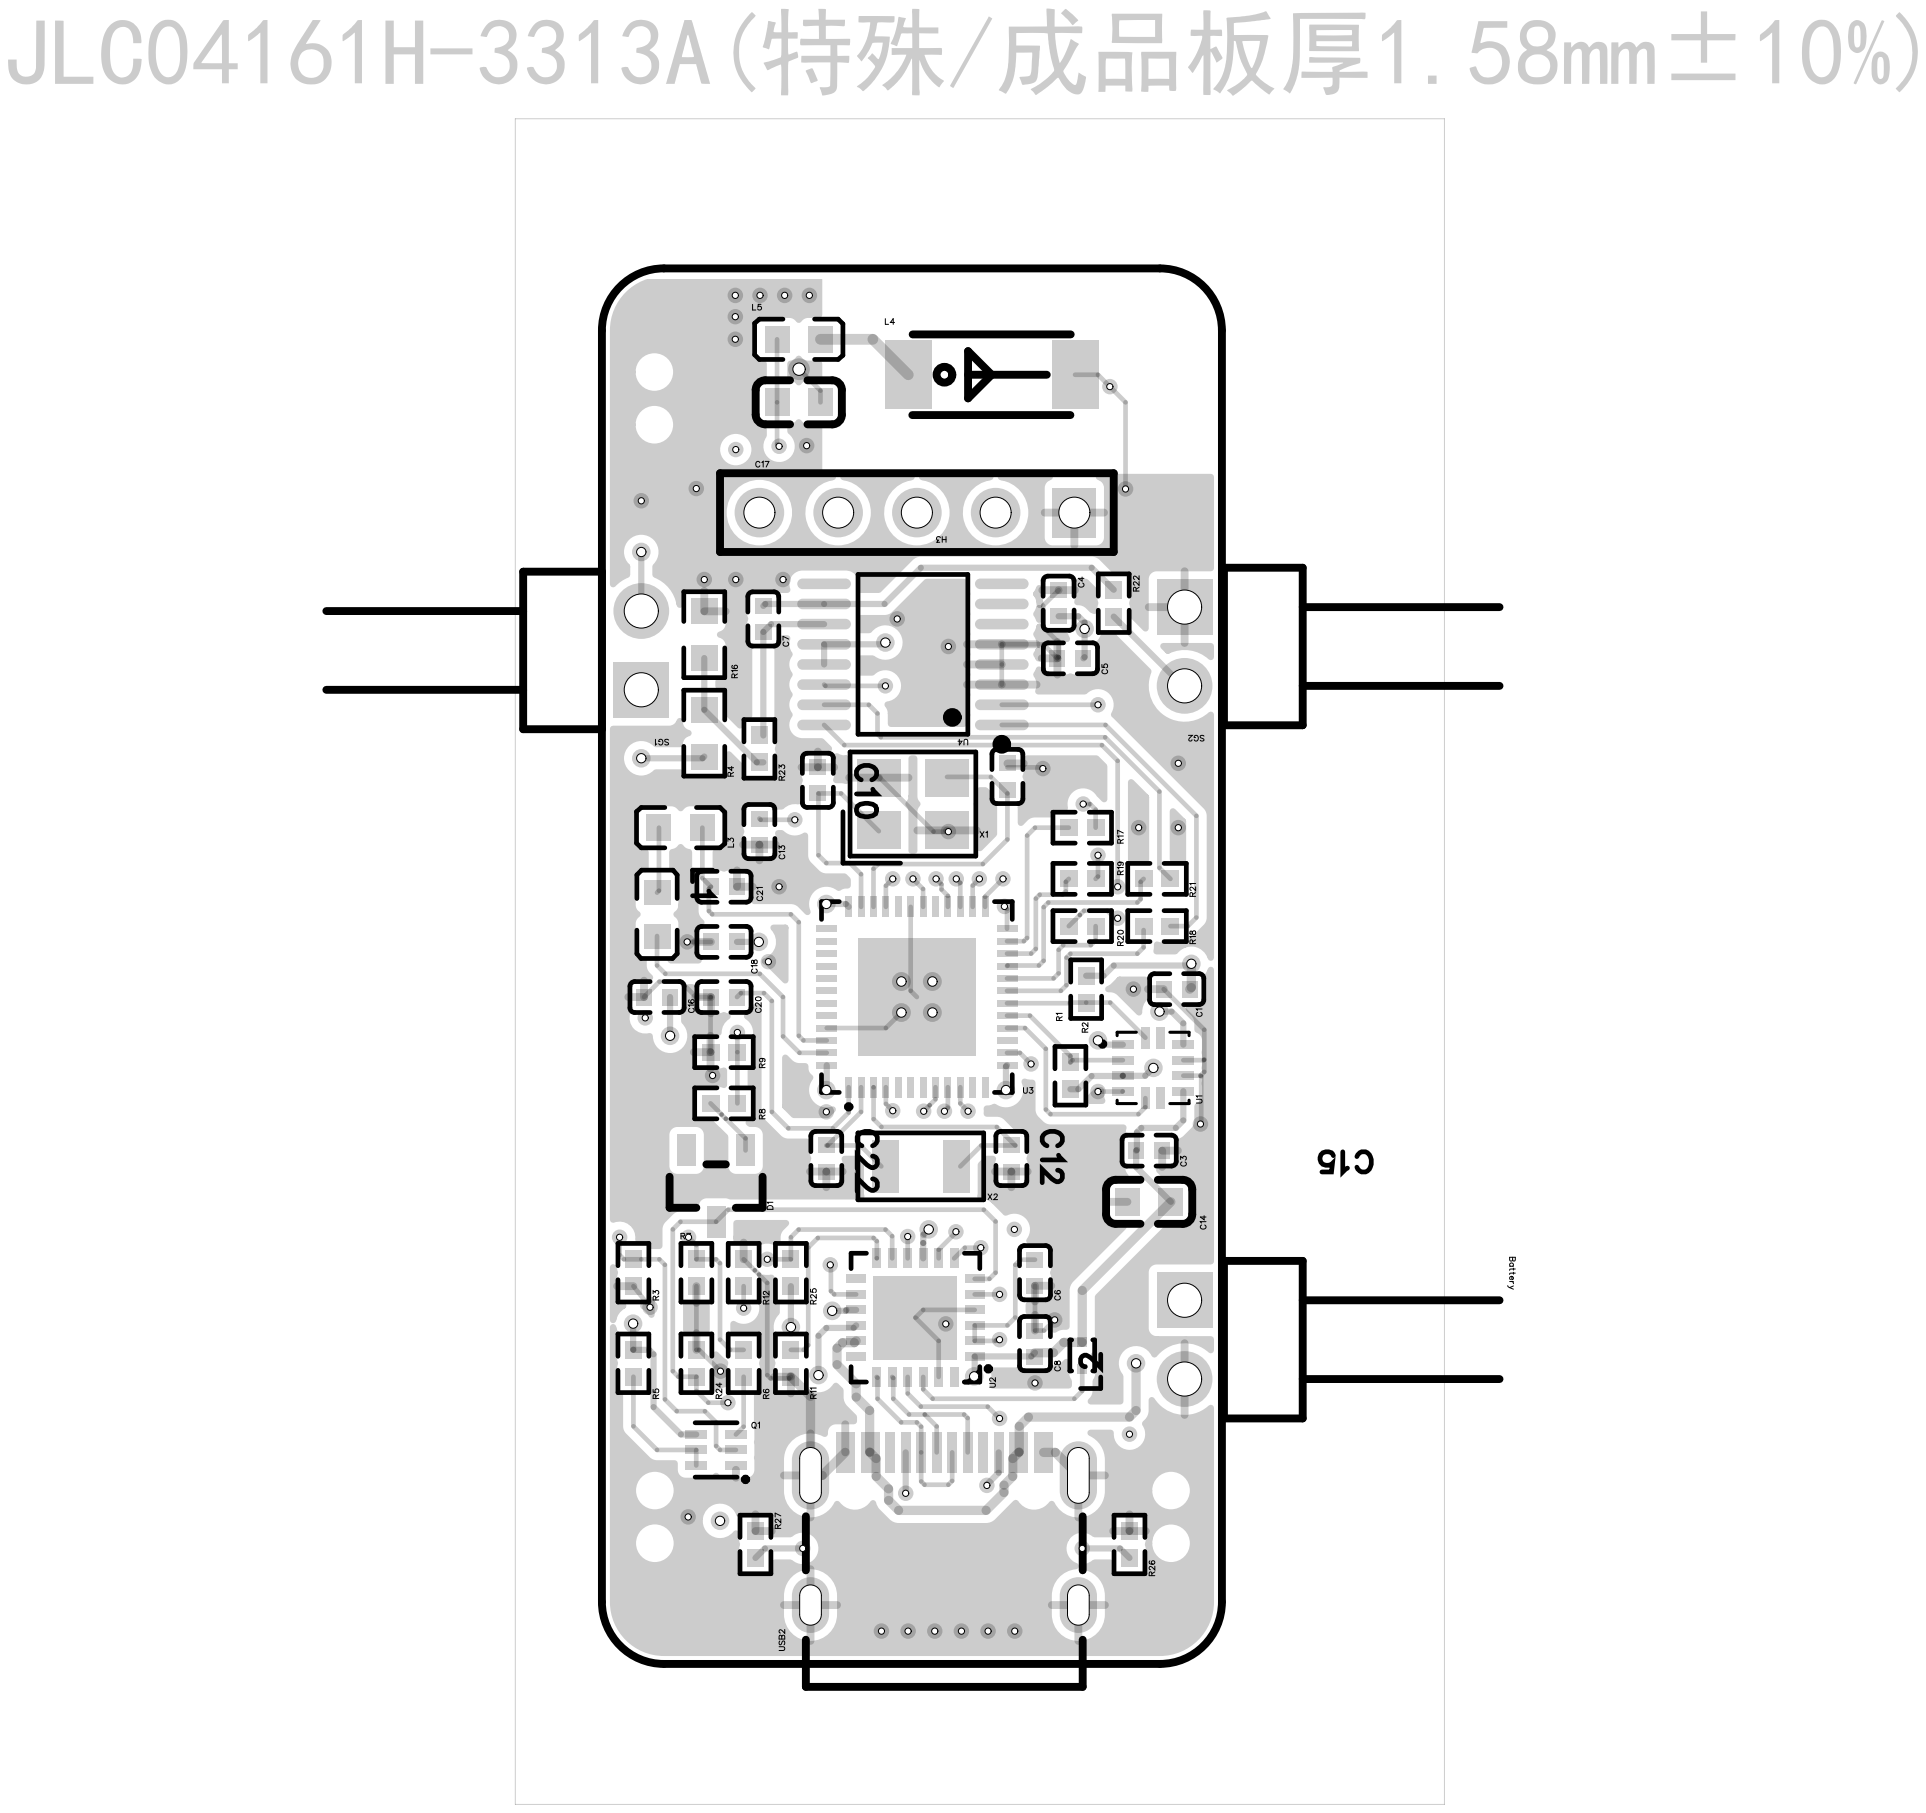
[picture p15: page 6]

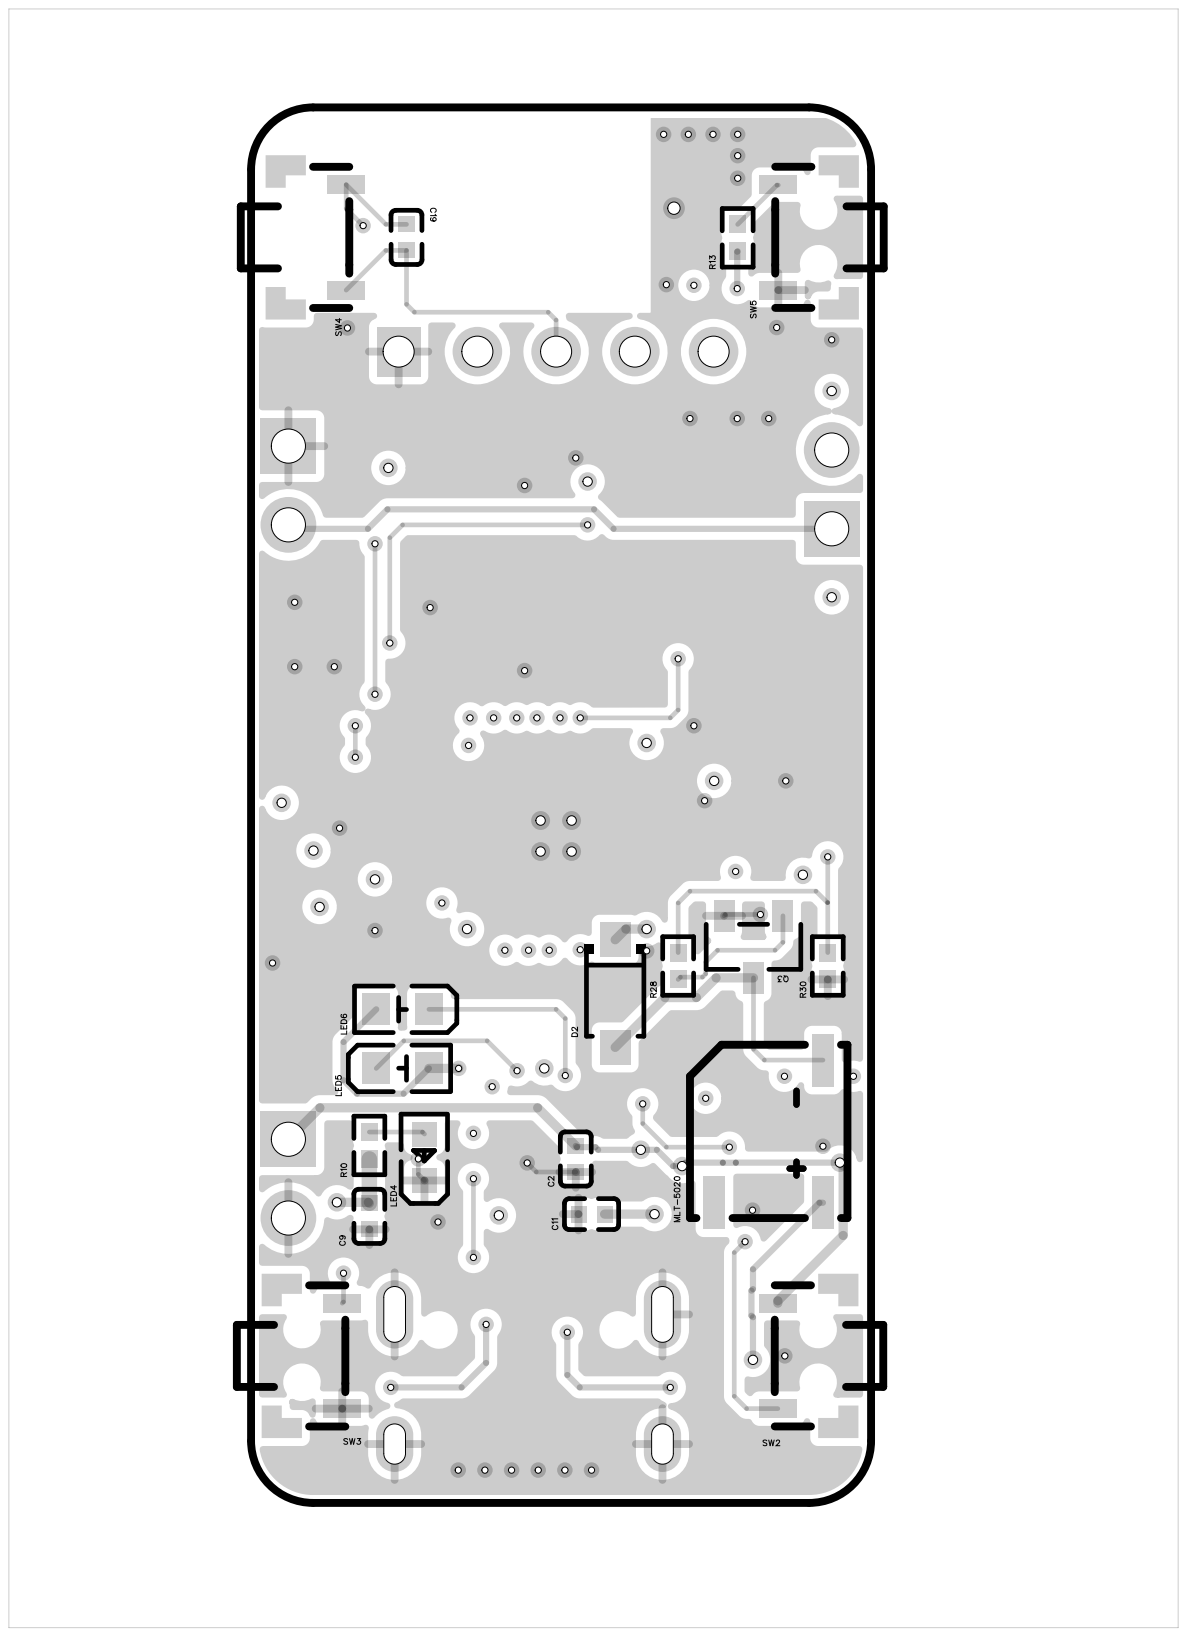
[picture p16: page 7]

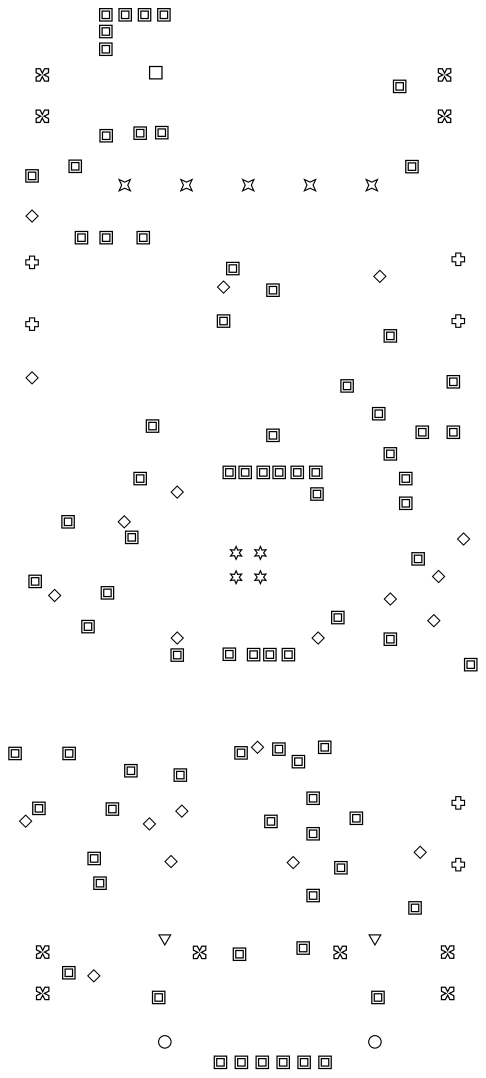
[picture p17: page 8]
