Swimers/Bicycle-Crank-Cadence-Power-Meter/Hardware/元器件/NPM1100/Schematic_Layout pdf files/PCA20057_Schematic_And_PCB.pdf

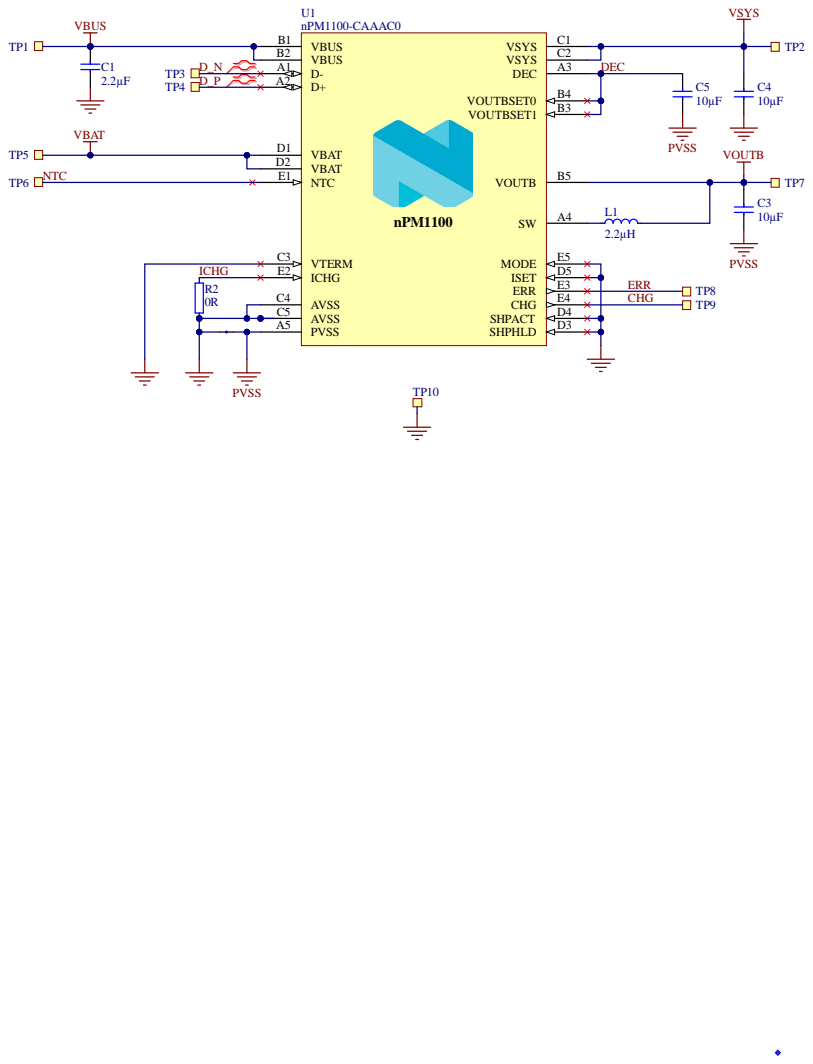
[picture p18: page 1]

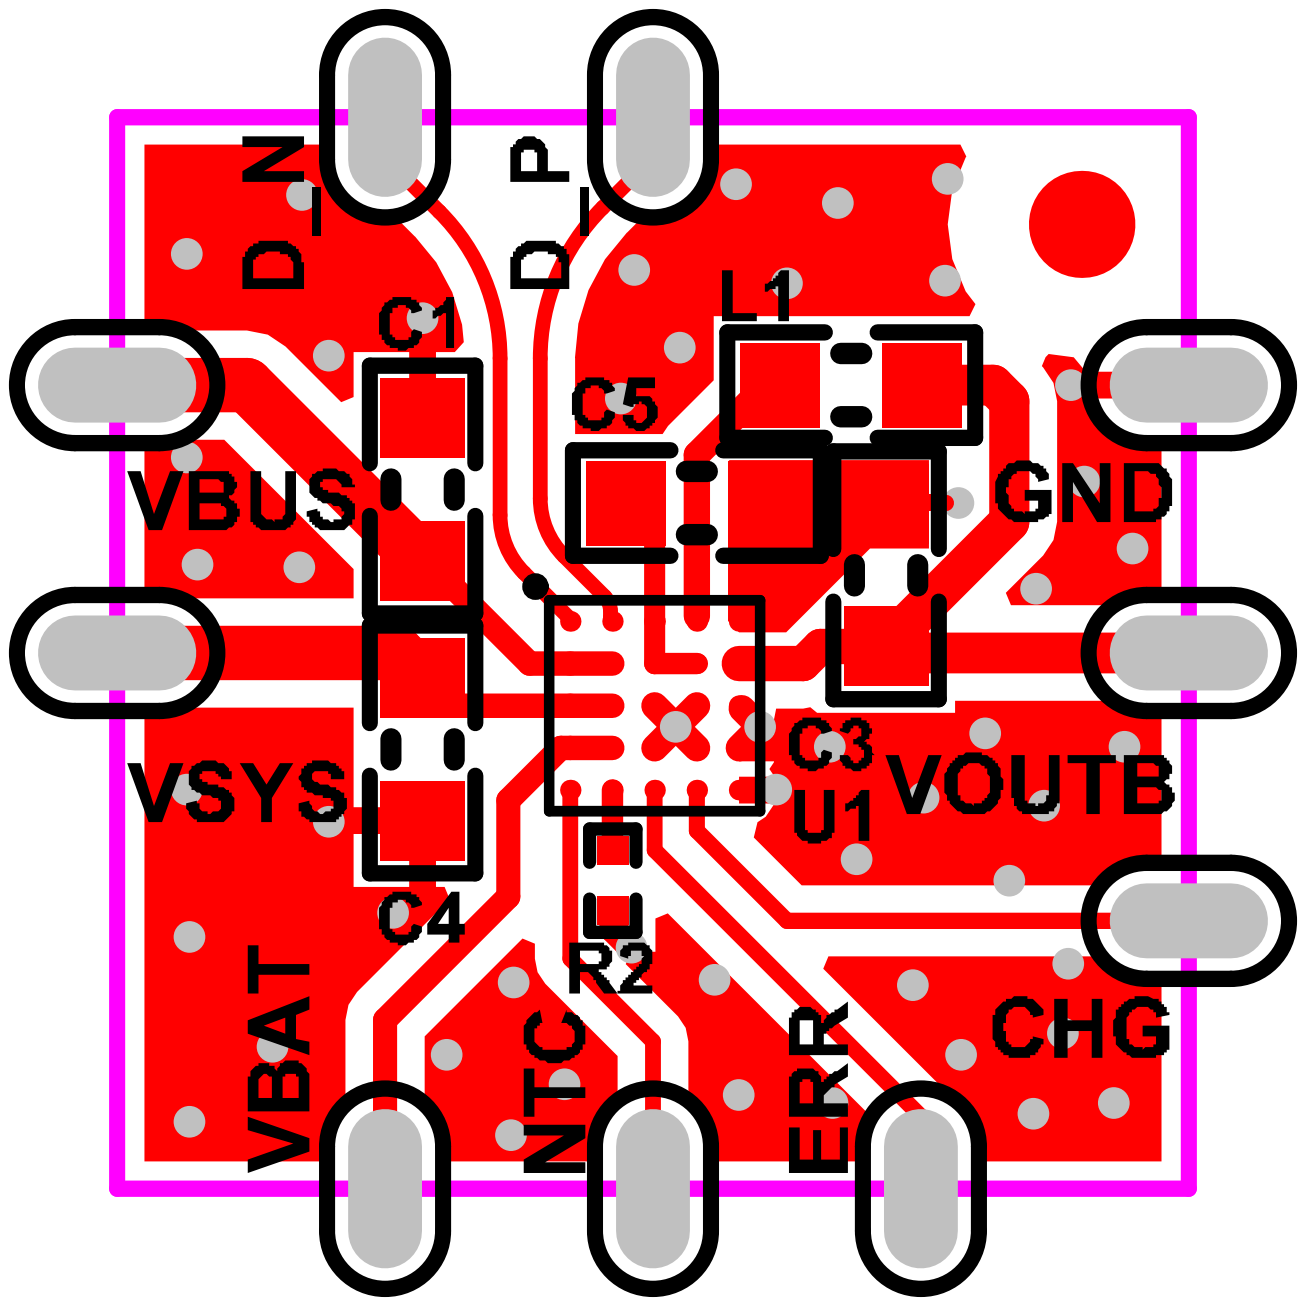
[picture p19: page 2]

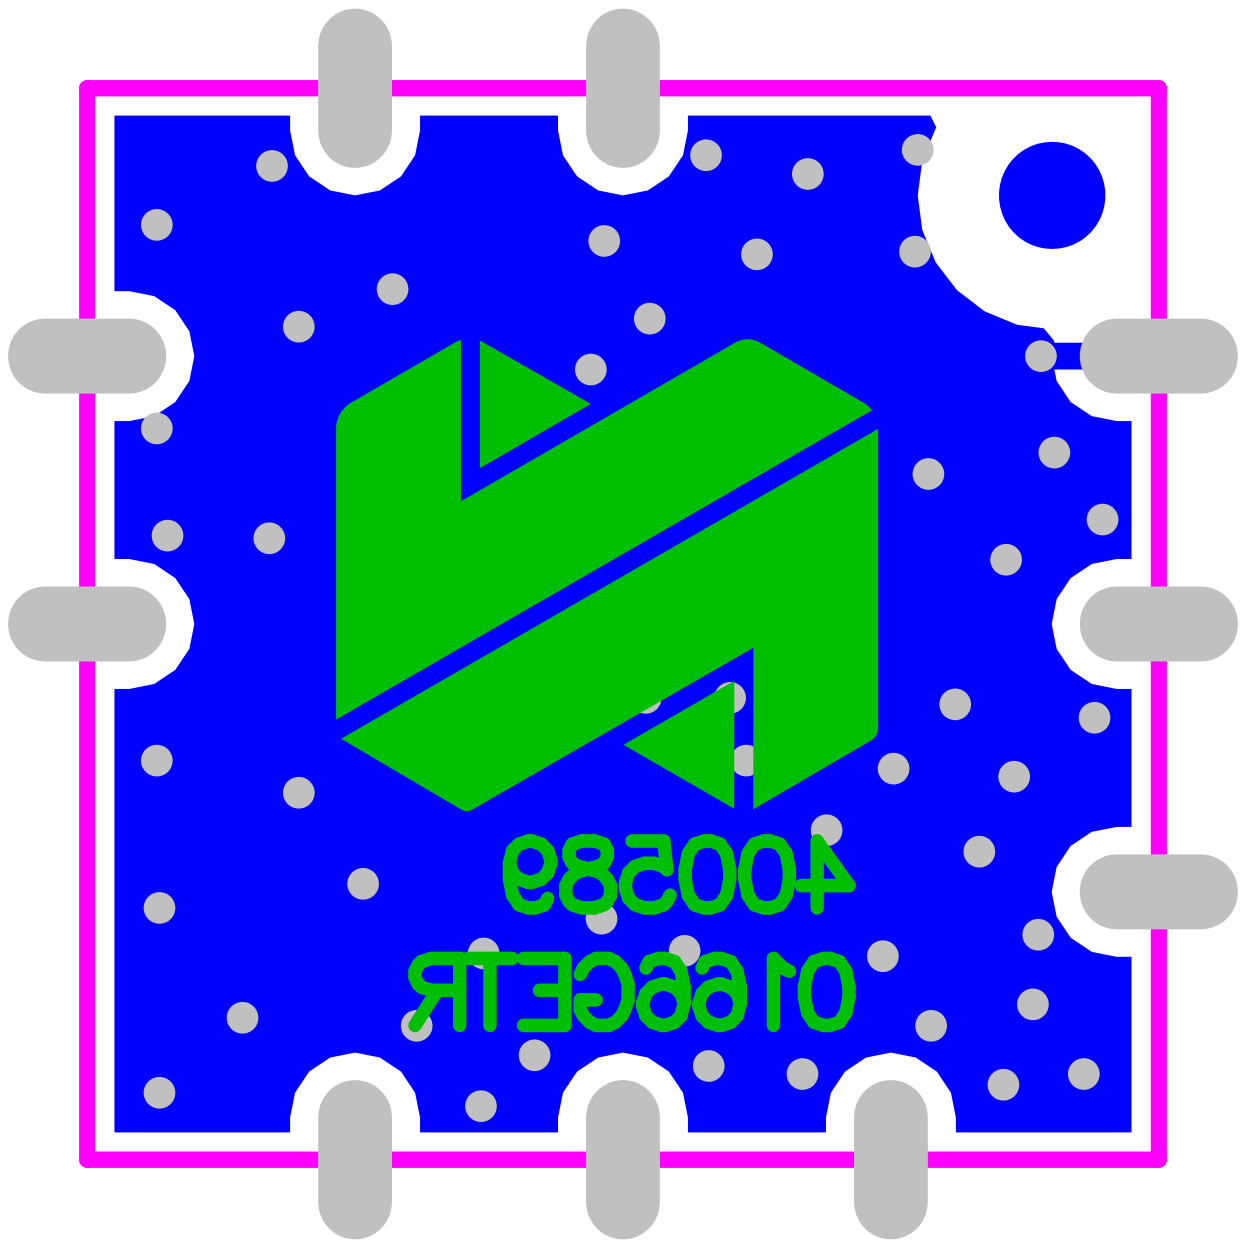
[picture p20: page 3]

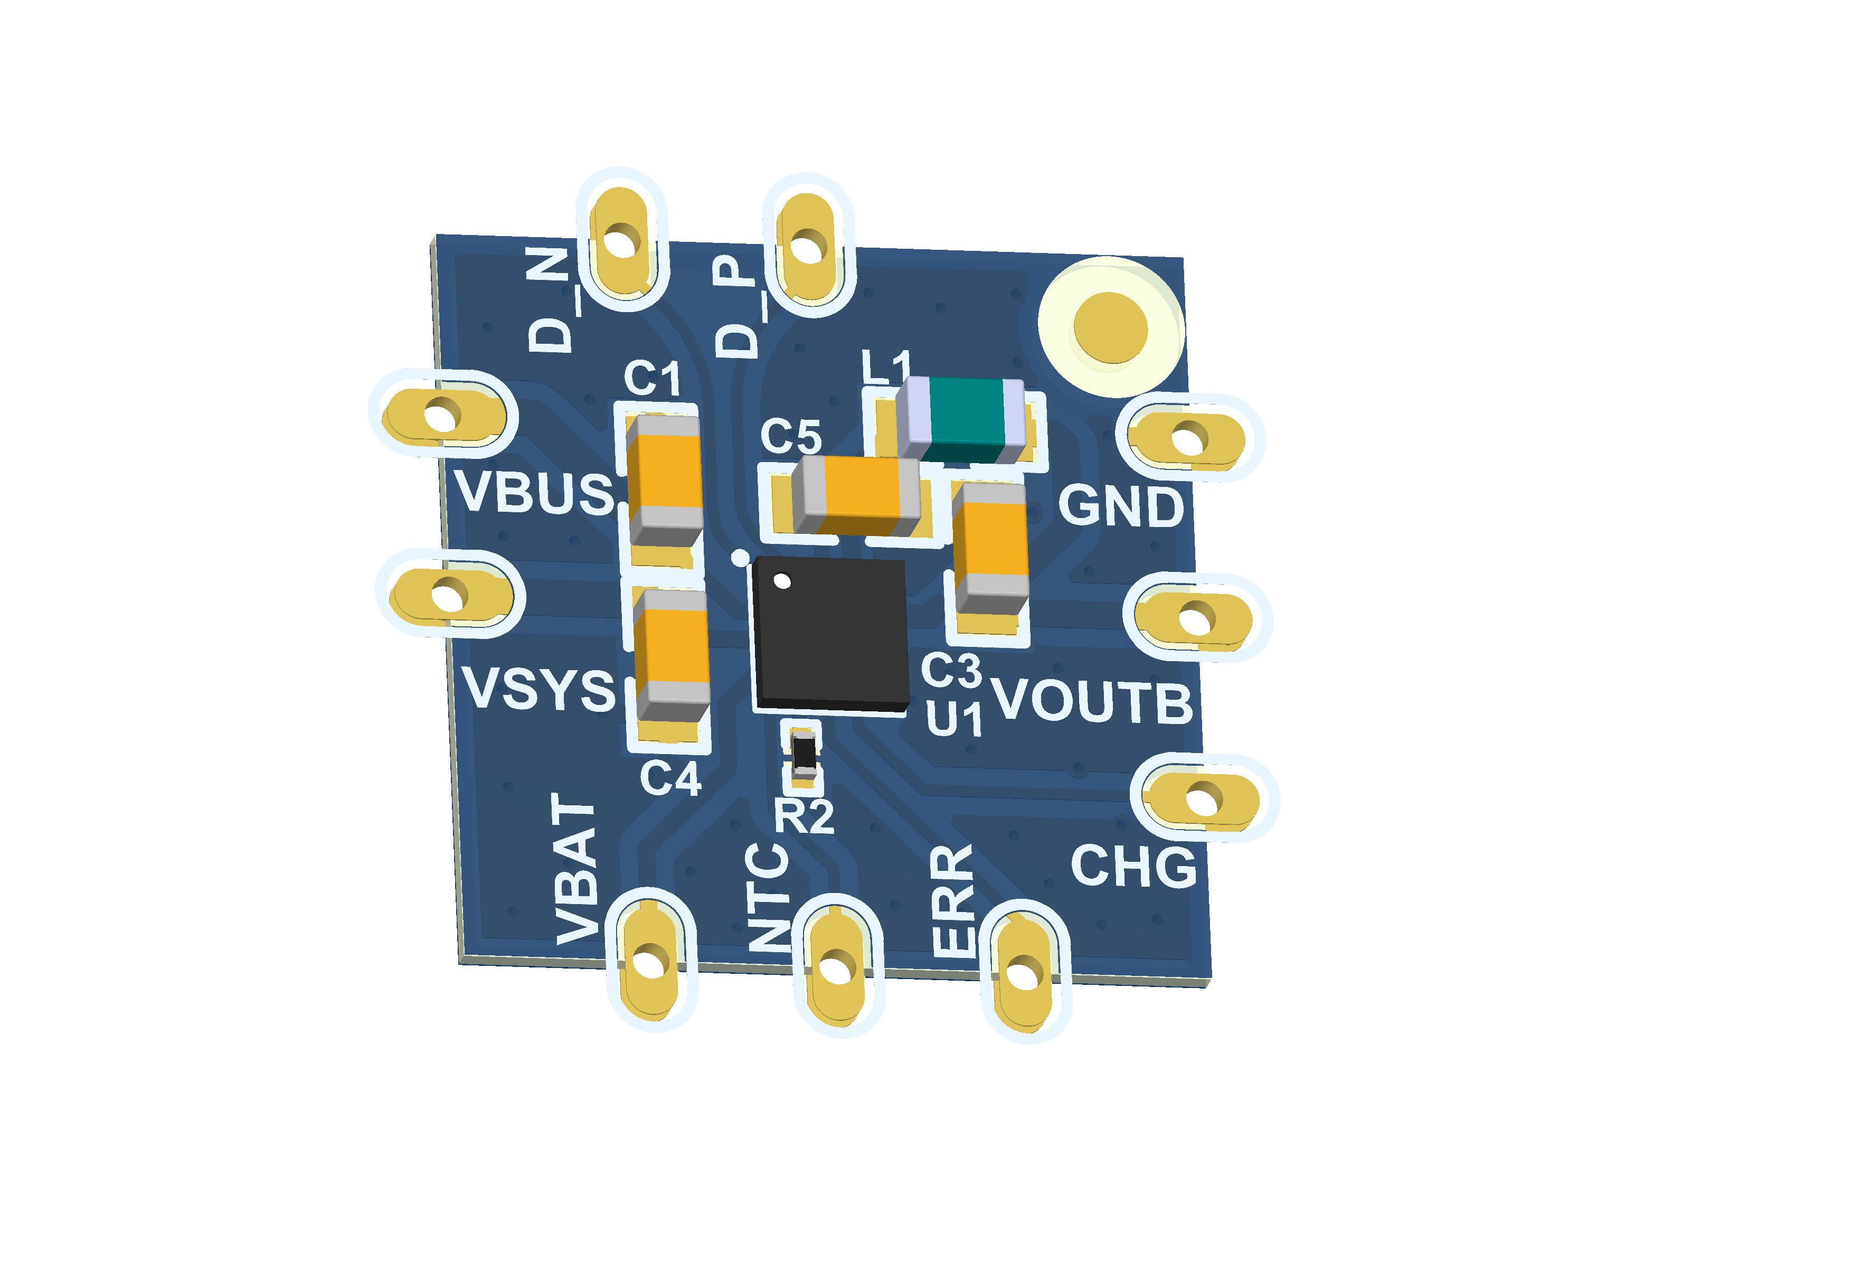
[picture p21: page 4]
