Swimers/Bicycle-Crank-Cadence-Power-Meter/Hardware/元器件/NPM1100/Production files/ASSEMBLY/400589_Assembly_Drawing.pdf

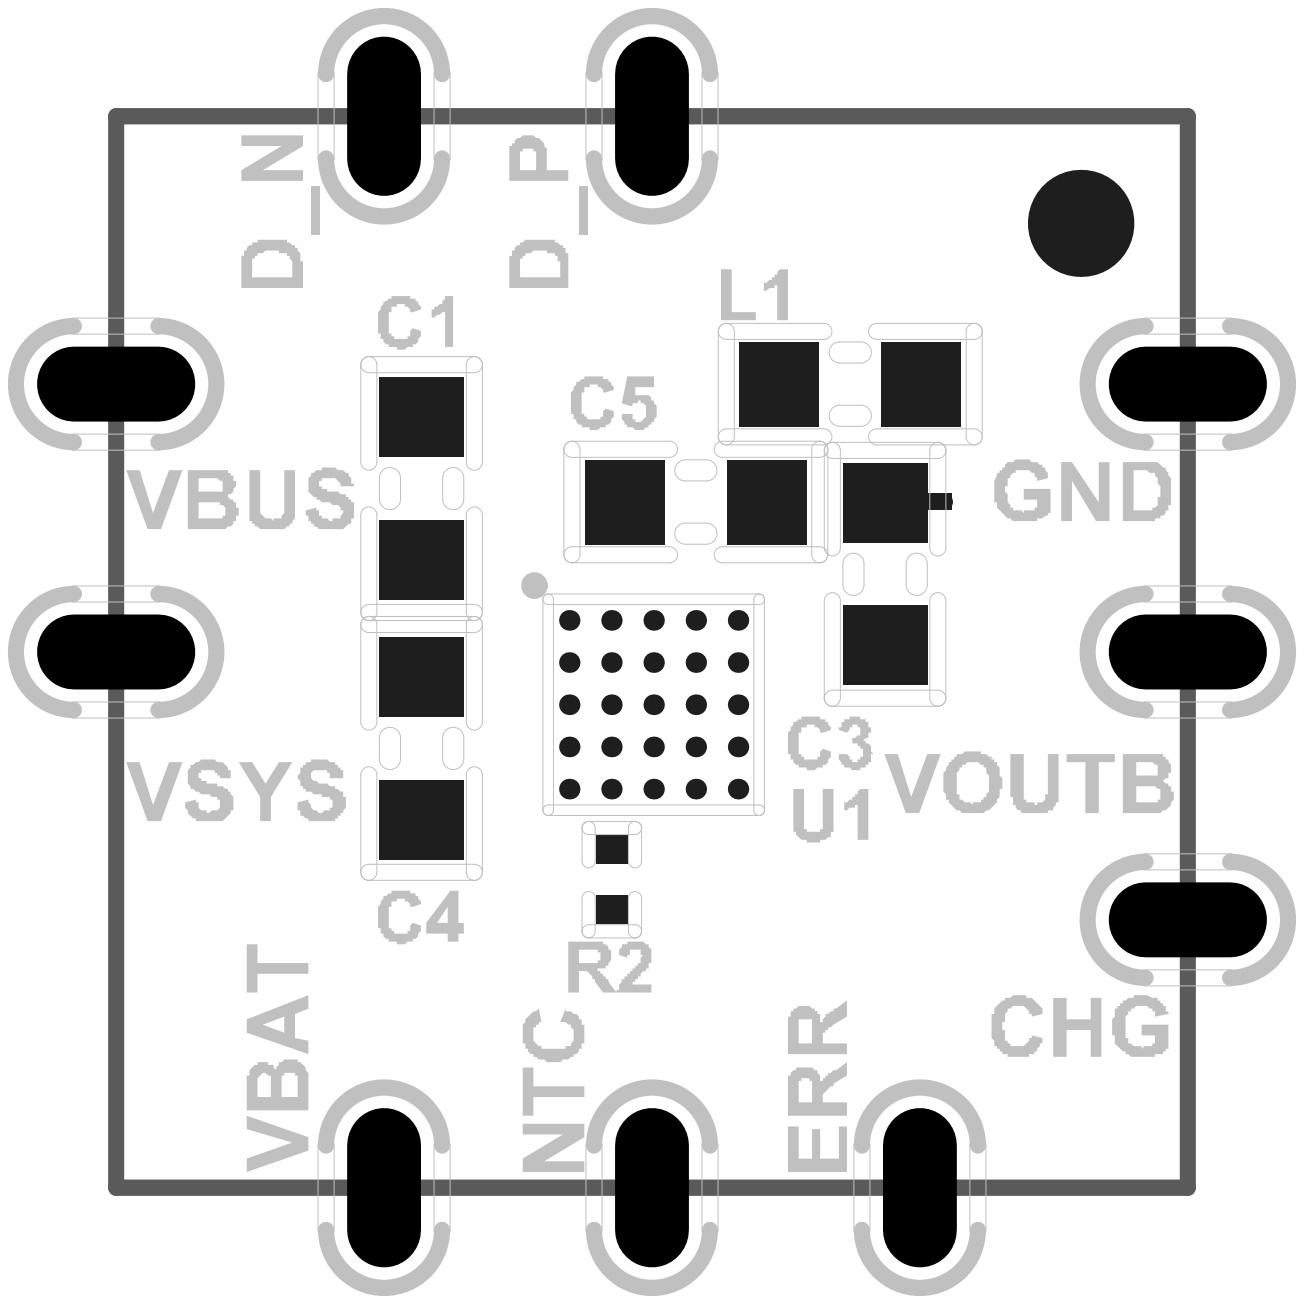
[picture p22: page 1]

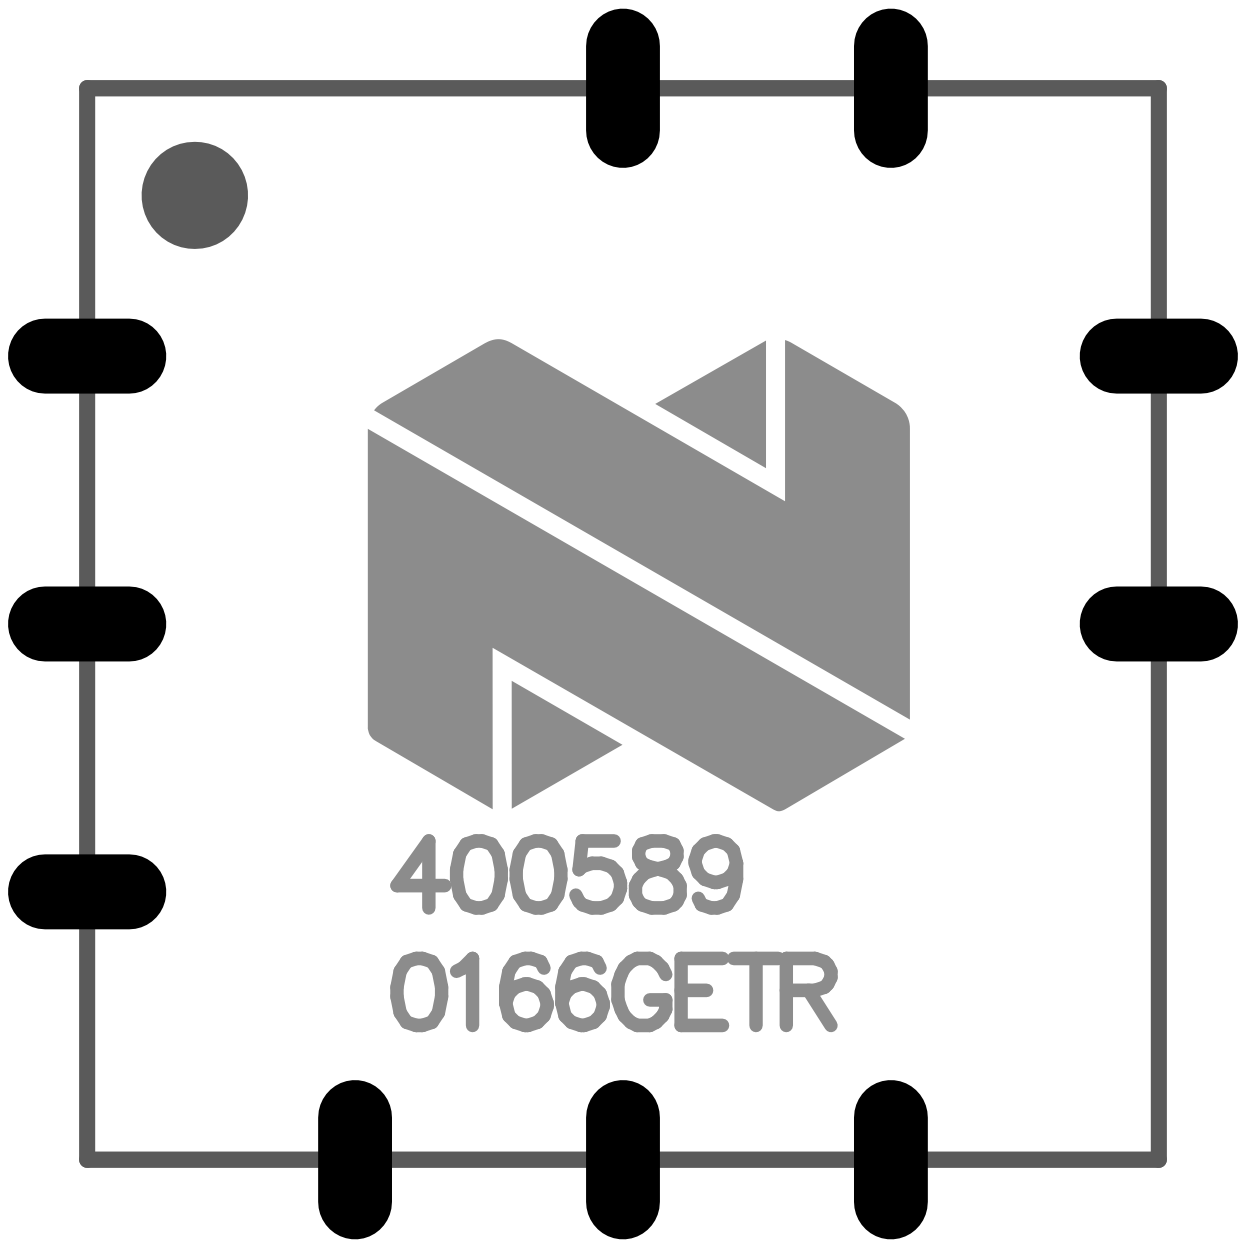
[picture p23: page 2]
