Swimers/Bicycle-Crank-Cadence-Power-Meter/(list of files, drawings)

Other design files:
Hardware/元器件/NPM1100/Altium Designer files_Kit/400535.PcbDoc
Hardware/元器件/NPM1100/Altium Designer files_Kit/400589.PcbDoc
Hardware/元器件/NPM1100/Altium Designer files_Kit/pca10123-sheet2_nPM1100.SchDoc
Hardware/元器件/NPM1100/Altium Designer files_Kit/pca10123-sheet3_misc.SchDoc
Hardware/元器件/NPM1100/Altium Designer files_Kit/pca10123.PrjPCB
Hardware/元器件/NPM1100/Altium Designer files_Kit/pca10123_sheet1_cover.SchDoc
Hardware/元器件/NPM1100/Altium Designer files_Kit/pca20057-nPM1100.SchDoc
Hardware/元器件/NPM1100/Altium Designer files_Kit/pca20057.PrjPCB
