Swimers/Bicycle-Crank-Cadence-Power-Meter/(commit log)

2026-11-01 Initialize CadenceSensor hardware project and non-commercial license
    [400535.PcbDoc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]
2026-11-02 制作带插针开发板
    [BOM_Board1_PCB1_2026-11-01.xlsx, 元器件采购.xlsx]
2026-11-03 开发板外设、引脚配置
2026-11-07 优化电路板
